im-deltax/Robodeltax/Trang_Phuc/Rap_Kimono_V20_mm.dxf

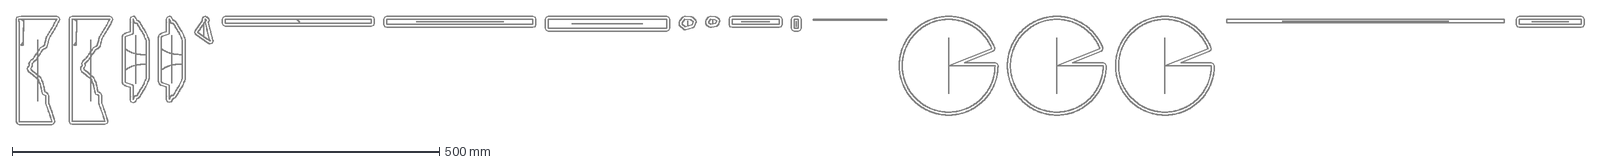
[picture p1: CAD file, 2026-10-22]
Trang_Phuc/Rap_Kimono_V20_mm.dxf
1834.3 x 126.7 mm
