im-deltax/Robodeltax/(list of files, cad)

Other CAD files:
Nguon_CAD_Giu_Lai/FreeCAD_V19/Micro_Duck_Cloak_V19_Assembly.FCStd
Nguon_CAD_Giu_Lai/Vo_nen_V11/Micro_Duck_Pumpkin_V11_A_Assembly.FCStd
Bien_Song_Trang_V11/May_Do_V11/02_Rap_V11_mm.dxf
Hoodie_Rong_Tim/Ho_So_May/02_Rap_Hoodie_Rong_Tim_mm.dxf
Hoodie_Rong_Tim_BANSAO/Ban_Sao_Vo_Ngoai_Theo_Anh/MicroDuck_VoNgoai_BANSAO.FCStd
Nguon_CAD_Giu_Lai/FreeCAD_V19/Micro_Duck_Cloak_V19_Cloak.step
Nguon_CAD_Giu_Lai/Robot_Kimono_V2.FCStd
Nguon_CAD_Giu_Lai/STEP/MagnetCapRight.step
Nguon_CAD_Giu_Lai/STL/K_LCD_den_tham_chieu.stl
Nguon_CAD_Giu_Lai/Vo_nen_V11/evidence/LCD_Module_Opaque_Reference.stl
Nguon_CAD_Giu_Lai/Vo_nen_V11/LCD_Display_Only.stl
Nguon_CAD_Giu_Lai/Vo_nen_V11/STL/Neck.stl
Thien_Van/Ho_So_May/Rap_Thien_Van_mm.dxf
Vo_In_3D/CAD/DELTAX_Man_1p9_V21.step
Vo_In_3D/STL/V16_Internal_head_locator.stl
Nguon_CAD_Giu_Lai/STEP/ArmLeft.step
Nguon_CAD_Giu_Lai/STL/K_LCD_noi_dung_tham_chieu.stl
Nguon_CAD_Giu_Lai/Vo_nen_V11/Lens_Thermoform_Male_Tool.step
Nguon_CAD_Giu_Lai/Vo_nen_V11/STL/USB_EndRail_Top_Piece_2.stl
Vo_In_3D/STL/HeadFront_LCD_1p9_V21.stl
Nguon_CAD_Giu_Lai/STEP/Lens_Rear_Opaque_Film.step
Nguon_CAD_Giu_Lai/Vo_nen_V11/STL/A_DeltaX_Engraved_Nameplate.stl
Vo_In_3D/STL/Base.stl
Nguon_CAD_Giu_Lai/STEP/LowerSupportInsert2.step
Nguon_CAD_Giu_Lai/Vo_nen_V11/STL/LCD_Front_Opaque_Shroud.stl
Vo_In_3D/STL/ArmRight.stl
Nguon_CAD_Giu_Lai/STEP/PumpkinHeadFront.step
Nguon_CAD_Giu_Lai/Vo_nen_V11/STL/PumpkinHeadRear.stl
Vo_In_3D/STL/A_DeltaX_Engraved_Nameplate.stl
Nguon_CAD_Giu_Lai/STEP/USB_EndRail_Top_Piece_2.step
Nguon_CAD_Giu_Lai/Vo_nen_V11/STL/Lens_PC_1p016_Target.stl
Vo_In_3D/STL/V16_Body_Front.stl
Nguon_CAD_Giu_Lai/STEP/PumpkinHeadRear.step
Nguon_CAD_Giu_Lai/Vo_nen_V11/STL/MagnetCapLeft.stl
Vo_In_3D/STL/LCD_Bracket_Left.stl
Nguon_CAD_Giu_Lai/STEP/Lens_Continuous_Gasket.step
Nguon_CAD_Giu_Lai/Vo_nen_V11/STL/MagnetCapRight.stl
Vo_In_3D/STL/SpeakerFrontRetainer.stl
Nguon_CAD_Giu_Lai/STEP/PumpkinBodyRear.step
Nguon_CAD_Giu_Lai/Vo_nen_V11/STL/LowerSupportInsert2.stl
Vo_In_3D/STL/LCD_Bracket_Right.stl
Nguon_CAD_Giu_Lai/STEP/Lens_PC_1p016_Target.step
Nguon_CAD_Giu_Lai/Vo_nen_V11/STL/LensSeatBezel.stl
Vo_In_3D/STL/HeadRear_LCD_1p9_V21.stl
Nguon_CAD_Giu_Lai/STEP/ArmRight.step
Nguon_CAD_Giu_Lai/Vo_nen_V11/STL/UpperSupportInsert2.stl
Vo_In_3D/STL/LCD_Light_Tunnel_V21.stl
Nguon_CAD_Giu_Lai/STEP/USB_EndRail_Top_Piece_1.step
Nguon_CAD_Giu_Lai/Vo_nen_V11/STL/UpperSupportInsert1.stl
Vo_In_3D/STL/V16_Body_Rear.stl
Nguon_CAD_Giu_Lai/STEP/A_DeltaX_Engraved_Nameplate.step
Nguon_CAD_Giu_Lai/Vo_nen_V11/STL/Lens_Rear_Opaque_Film.stl
Vo_In_3D/STL/V16_Arm_locating_peg_-1.stl
Nguon_CAD_Giu_Lai/STEP/K_Mat_cuoi_minh_hoa.step
Nguon_CAD_Giu_Lai/Vo_nen_V11/STL/Lens_Continuous_Gasket.stl
Vo_In_3D/STL/BaseCover.stl
Nguon_CAD_Giu_Lai/STEP/UpperSupportInsert1.step
Nguon_CAD_Giu_Lai/Vo_nen_V11/STL/A_DeltaX_Recessed_Gold_Inlay.stl
Vo_In_3D/STL/A_DeltaX_Recessed_Gold_Inlay.stl
Nguon_CAD_Giu_Lai/STEP/MagnetCapLeft.step
Nguon_CAD_Giu_Lai/Vo_nen_V11/STL/BaseCover.stl
Vo_In_3D/STL/ArmLeft.stl
Nguon_CAD_Giu_Lai/STEP/V11_Internal_Core_Pedestal.step
Nguon_CAD_Giu_Lai/Vo_nen_V11/STL/PumpkinBodyRear.stl
Nguon_CAD_Giu_Lai/STEP/BaseCover.step
Nguon_CAD_Giu_Lai/Vo_nen_V11/STL/V11_Internal_Core_Pedestal.stl
Nguon_CAD_Giu_Lai/STEP/Neck.step
Nguon_CAD_Giu_Lai/Vo_nen_V11/STL/USB_EndRail_Top_Piece_1.stl
Nguon_CAD_Giu_Lai/STEP/LensSeatBezel.step
Nguon_CAD_Giu_Lai/Vo_nen_V11/STL/PumpkinBodyFront.stl
Nguon_CAD_Giu_Lai/STEP/LCD_Front_Opaque_Shroud.step
Nguon_CAD_Giu_Lai/Vo_nen_V11/STL/USB_EndRail_Bottom.stl
Nguon_CAD_Giu_Lai/STEP/USB_EndRail_Bottom.step
Nguon_CAD_Giu_Lai/Vo_nen_V11/STL/Base.stl
Nguon_CAD_Giu_Lai/STEP/UpperSupportInsert2.step
Nguon_CAD_Giu_Lai/Vo_nen_V11/STL/PumpkinHeadFront.stl
Nguon_CAD_Giu_Lai/STEP/LowerSupportInsert1.step
Nguon_CAD_Giu_Lai/Vo_nen_V11/STL/SpeakerFrontRetainer.stl
Nguon_CAD_Giu_Lai/STEP/PumpkinBodyFront.step
Nguon_CAD_Giu_Lai/Vo_nen_V11/STL/LowerSupportInsert1.stl
Nguon_CAD_Giu_Lai/STEP/SpeakerFrontRetainer.step
Nguon_CAD_Giu_Lai/STEP/Base.step
Nguon_CAD_Giu_Lai/STEP/A_DeltaX_Recessed_Gold_Inlay.step
Bien_Song_Trang_V11/Robot_Bien_Song_Trang_V11.blend
Blender/Robot_Kimono_Man_1p9_V21.blend
Hoodie_Rong_Tim/Micro_Duck_Hoodie_Rong_Tim.blend
Hoodie_Rong_Tim_BANSAO/Ban_Sao_Vo_Ngoai_Theo_Anh/MicroDuck_HoodieRong_VoNgoai_BANSAO.blend
Hoodie_Rong_Tim_BANSAO/Ban_Theo_Dac_Ta_Ni_Bong/MicroDuck_HoodieRong_NiBong_BANSAO.blend
Hoodie_Rong_Tim_BANSAO/Ban_Tu_Kiem_Tra/MicroDuck_HoodieRong_TuKiemTra_BANSAO.blend
Hoodie_Rong_Tim_BANSAO/Bo_Trang_Phuc_Day_Du/MicroDuck_HoodieRong_DayDu_BANSAO.blend
Hoodie_Rong_Tim_BANSAO/MicroDuck_HoodieRong_BANSAO.blend
Hoodie_Rong_Tim_ThietKeMoi/MicroDuck_HoodieRong_BANSAO.blend
Nguon_CAD_Giu_Lai/FreeCAD_V19/Micro_Duck_Cloak_V19_Cloak.FCStd
Nguon_CAD_Giu_Lai/STL/A_DeltaX_Engraved_Nameplate.stl
Nguon_CAD_Giu_Lai/STL/A_DeltaX_Recessed_Gold_Inlay.stl
Nguon_CAD_Giu_Lai/STL/ArmLeft.stl
Nguon_CAD_Giu_Lai/STL/ArmRight.stl
Nguon_CAD_Giu_Lai/STL/Base.stl
Nguon_CAD_Giu_Lai/STL/BaseCover.stl
Nguon_CAD_Giu_Lai/STL/K_Mat_cuoi_minh_hoa.stl
Nguon_CAD_Giu_Lai/STL/LCD_Front_Opaque_Shroud.stl
Nguon_CAD_Giu_Lai/STL/LensSeatBezel.stl
Nguon_CAD_Giu_Lai/STL/Lens_Continuous_Gasket.stl
Nguon_CAD_Giu_Lai/STL/Lens_PC_1p016_Target.stl
Nguon_CAD_Giu_Lai/STL/Lens_Rear_Opaque_Film.stl
Nguon_CAD_Giu_Lai/STL/LowerSupportInsert1.stl
Nguon_CAD_Giu_Lai/STL/LowerSupportInsert2.stl
Nguon_CAD_Giu_Lai/STL/MagnetCapLeft.stl
Nguon_CAD_Giu_Lai/STL/MagnetCapRight.stl
Nguon_CAD_Giu_Lai/STL/Neck.stl
Nguon_CAD_Giu_Lai/STL/PumpkinBodyFront.stl
Nguon_CAD_Giu_Lai/STL/PumpkinBodyRear.stl
Nguon_CAD_Giu_Lai/STL/PumpkinHeadFront.stl
Nguon_CAD_Giu_Lai/STL/PumpkinHeadRear.stl
Nguon_CAD_Giu_Lai/STL/SpeakerFrontRetainer.stl
Nguon_CAD_Giu_Lai/STL/USB_EndRail_Bottom.stl
Nguon_CAD_Giu_Lai/STL/USB_EndRail_Top_Piece_1.stl
Nguon_CAD_Giu_Lai/STL/USB_EndRail_Top_Piece_2.stl
Nguon_CAD_Giu_Lai/STL/UpperSupportInsert1.stl
Nguon_CAD_Giu_Lai/STL/UpperSupportInsert2.stl
Nguon_CAD_Giu_Lai/STL/V11_Internal_Core_Pedestal.stl
Thien_Van/Robot_Thien_Van.blend
Vo_In_3D/CAD/DELTAX_Man_1p9_V21.FCStd
Vo_In_3D/STL/V16_Arm_locating_peg_1.stl
