im-deltax/Robodeltax/Dien_Tu/KiCad/Charge_Port/DELTAX_V2_Charge_Port.kicad_pcb

## KiCad design Dien_Tu/KiCad/Charge_Port/DELTAX_V2_Charge_Port.kicad_pcb (2026-10-22)

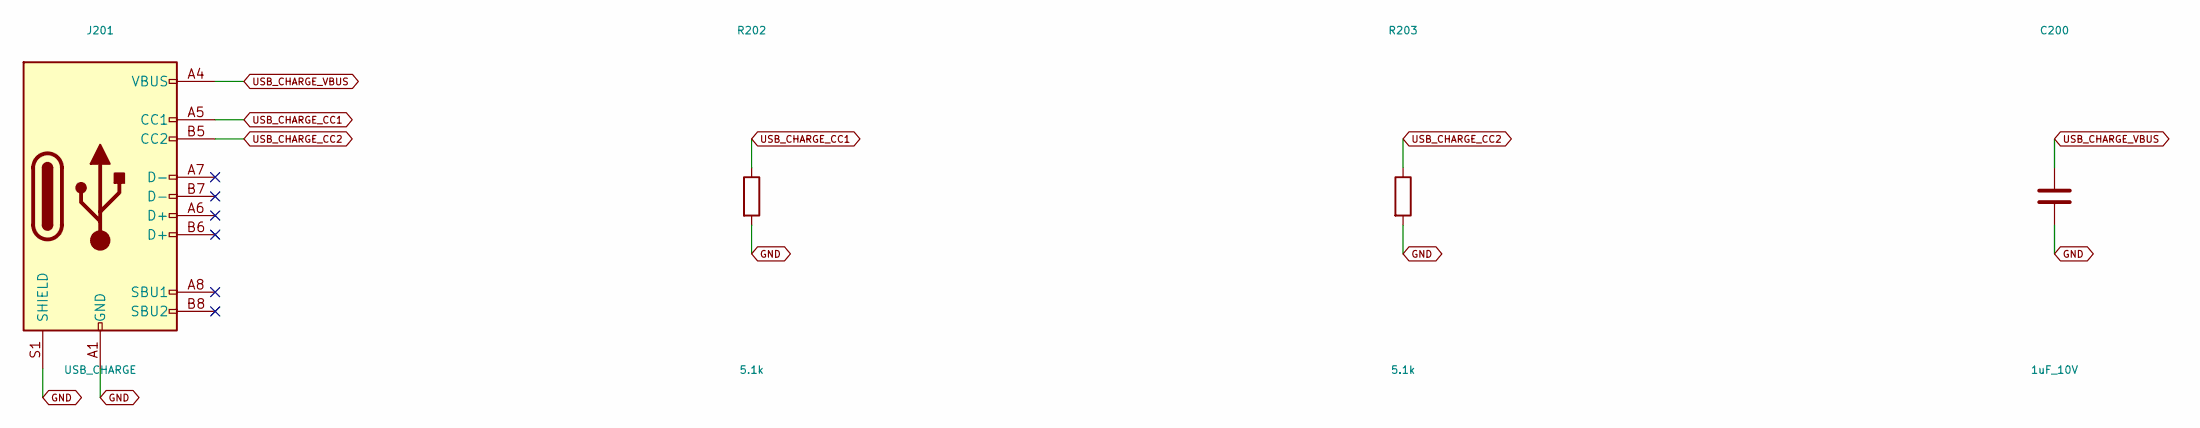
[picture p2: schematic Charge_Port_09_USB_Charge.kicad_sch]

Parts:
C200: 1uF_10V; C_0603_1608Metric
J201: USB_CHARGE; USB_C_Receptacle_GCT_USB4105-xx-A_16P_TopMnt_Horizontal
R202, R203: 5.1k; R_0603_1608Metric

Connections:
GND: C200.2, J201.A1 (GND), J201.A12 (GND), J201.B1 (GND), J201.B12 (GND), J201.S1 (SHIELD), R202.2, R203.2; also elsewhere on the board
USB_CHARGE_CC1: J201.A5 (CC1), R202.1
USB_CHARGE_CC2: J201.B5 (CC2), R203.1
USB_CHARGE_VBUS: C200.1, J201.A4 (VBUS), J201.A9 (VBUS), J201.B4 (VBUS), J201.B9 (VBUS); also elsewhere on the board

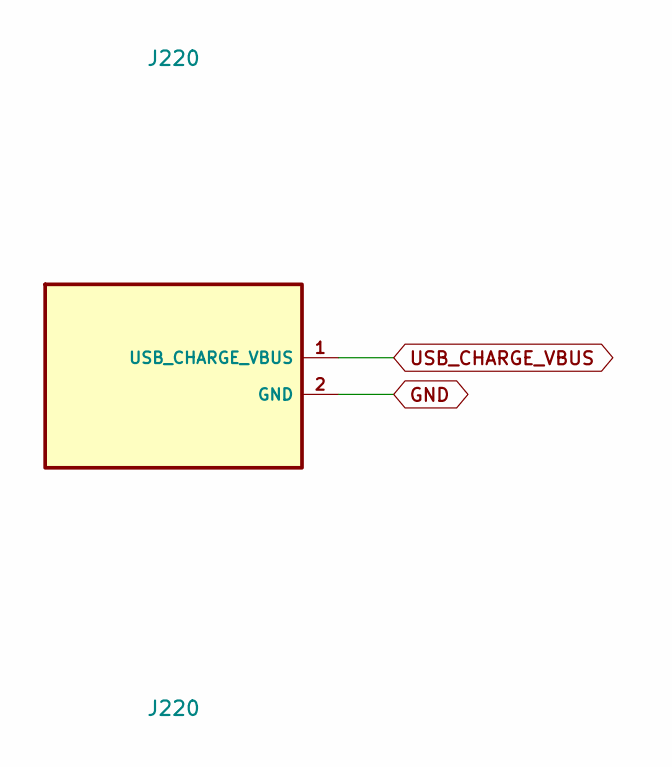
[picture p3: schematic Charge_Port_Interface.kicad_sch]

Parts:
J220: J220; PowerPads_2

Connections:
GND: J220.2 (GND); also elsewhere on the board
USB_CHARGE_VBUS: J220.1 (USB_CHARGE_VBUS); also elsewhere on the board

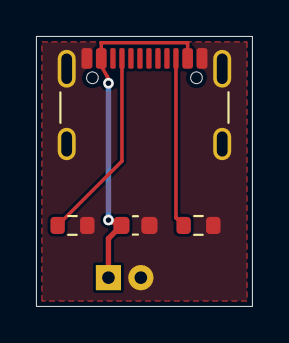
[picture p4: board DELTAX_V2_Charge_Port.kicad_pcb from above]

Board: 2 copper layers, 12.0 x 15.0 mm, 5 parts (0 on the bottom side), 4 nets.
