im-deltax/Robodeltax/Dien_Tu/KiCad/Head/DELTAX_V2_Head.kicad_pcb

## KiCad design Dien_Tu/KiCad/Head/DELTAX_V2_Head.kicad_pcb (2026-10-22)

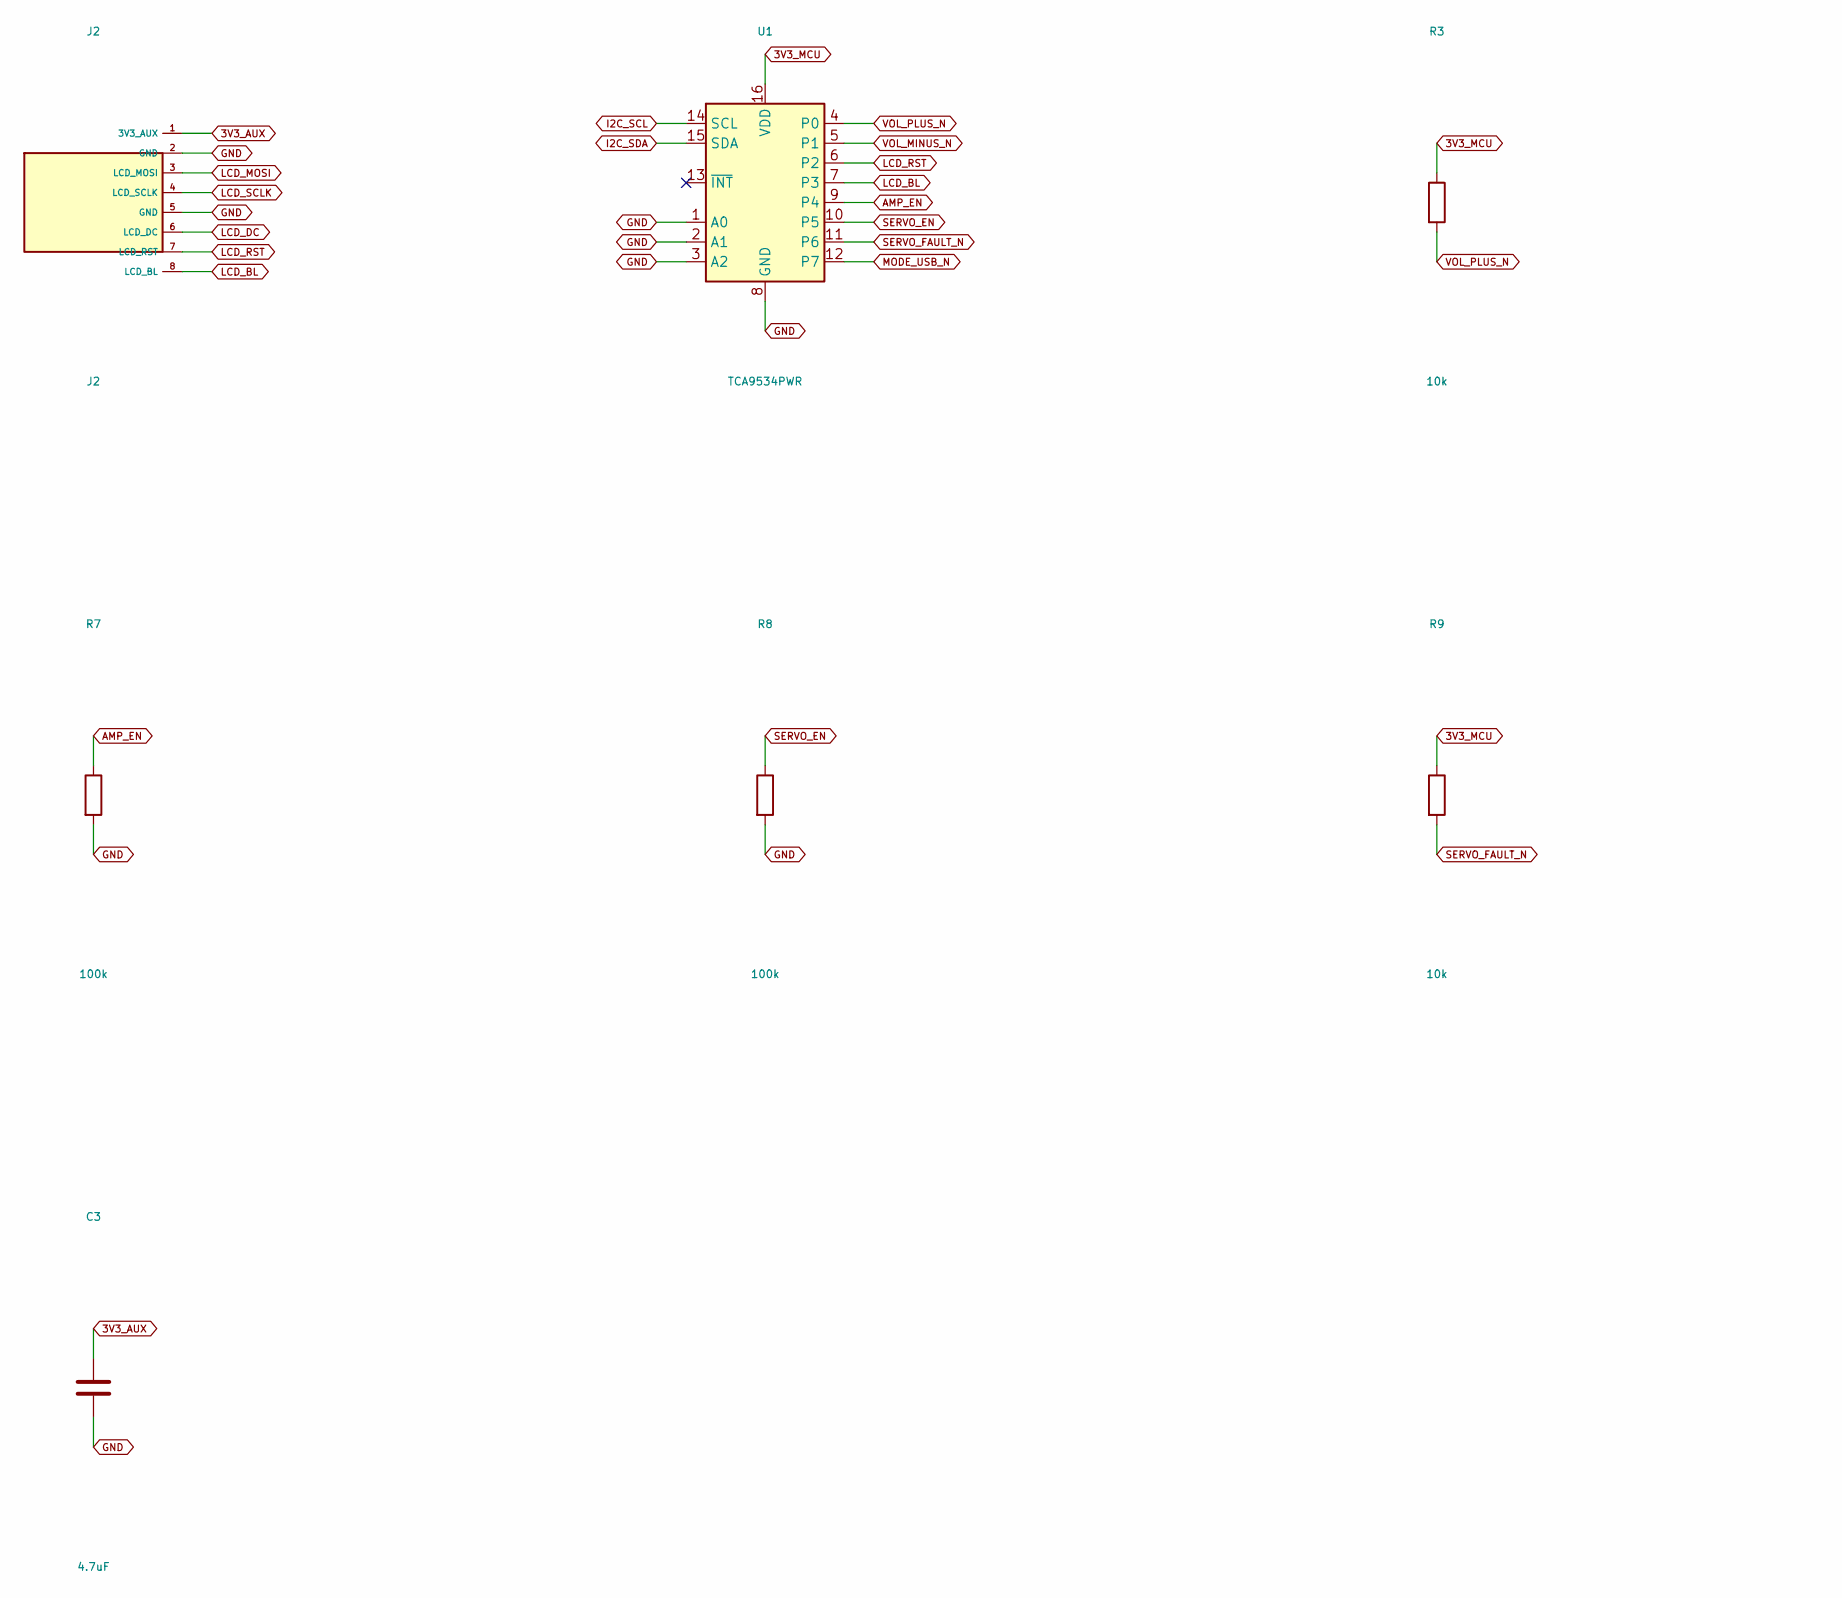
[picture p5: schematic Head_01_Module_LCD_Control.kicad_sch, part in row 1, column 1]

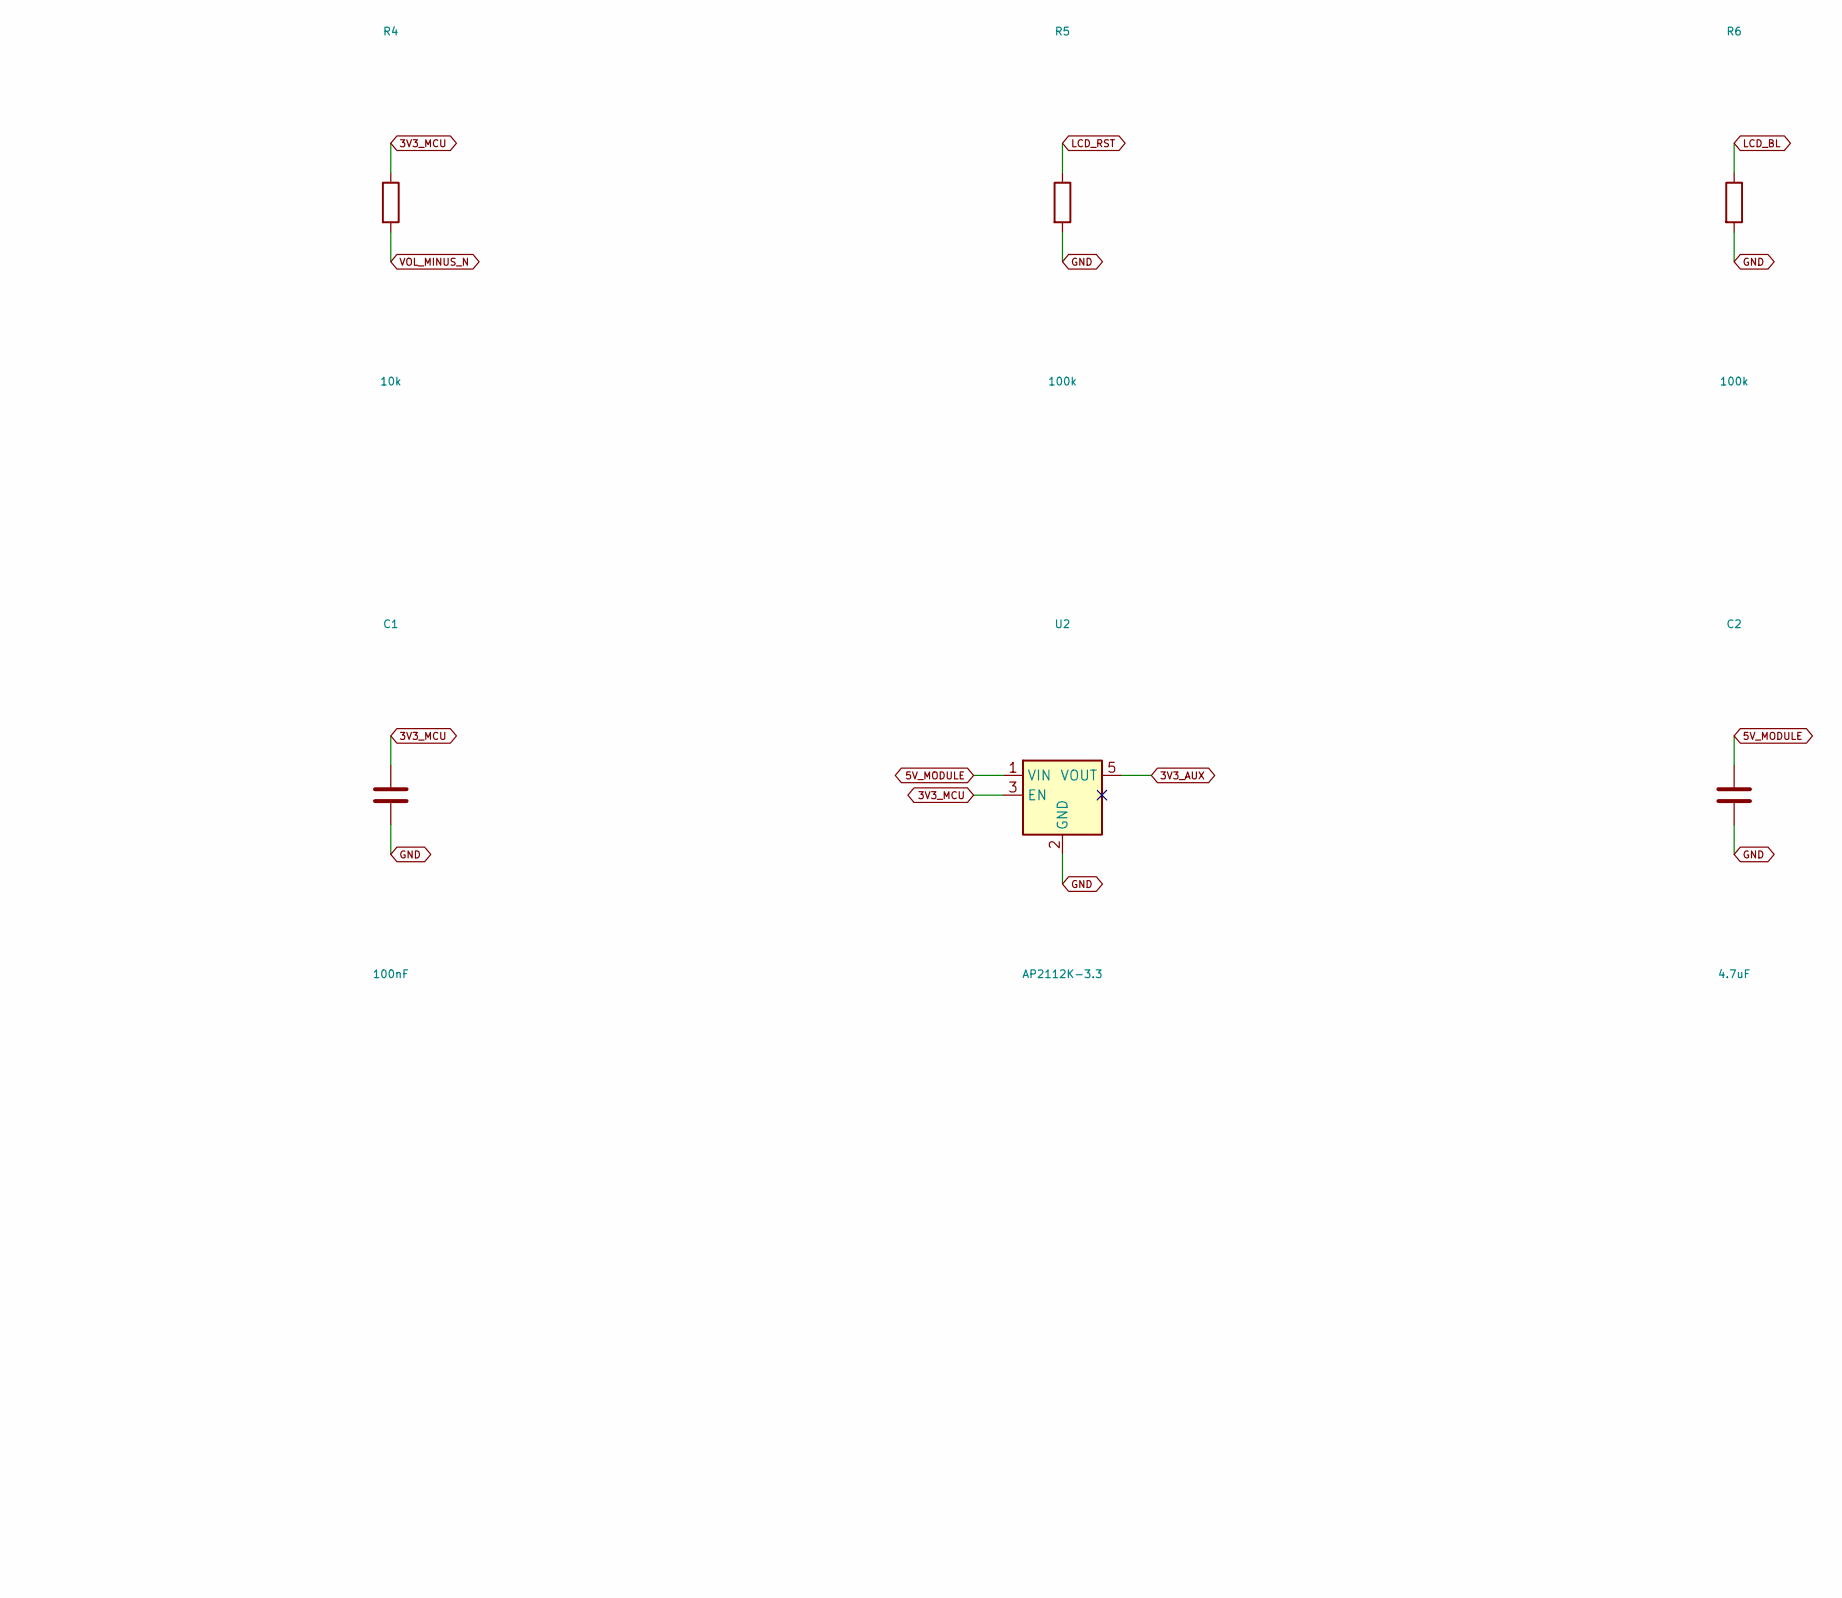
[picture p6: schematic Head_01_Module_LCD_Control.kicad_sch, part in row 1, column 2]

Parts:
C1: 100nF; C_0603_1608Metric
C2, C3: 4.7uF; C_0603_1608Metric
J2: J2; JST_GH_SM08B-GHS-TB_1x08-1MP_P1.25mm_Horizontal
R3, R4, R9: 10k; R_0603_1608Metric
R5, R6, R7, R8: 100k; R_0603_1608Metric
U1: TCA9534PWR; TSSOP-16_4.4x5mm_P0.65mm
U2: AP2112K-3.3; SOT-23-5

Connections:
3V3_AUX: C3.1, J2.1 (3V3_AUX), U2.5 (VOUT)
3V3_MCU: C1.1, R3.1, R4.1, R9.1, U1.16 (VDD), U2.3 (EN); also elsewhere on the board
5V_MODULE: C2.1, U2.1 (VIN); also elsewhere on the board
AMP_EN: R7.1, U1.9 (P4); also elsewhere on the board
GND: C1.2, C2.2, C3.2, J2.2 (GND), J2.5 (GND), R5.2, R6.2, R7.2, R8.2, U1.1 (A0), U1.2 (A1), U1.3 (A2), U1.8 (GND), U2.2 (GND); also elsewhere on the board
I2C_SCL: U1.14 (SCL); also elsewhere on the board
I2C_SDA: U1.15 (SDA); also elsewhere on the board
LCD_BL: J2.8 (LCD_BL), R6.1, U1.7 (P3)
LCD_DC: J2.6 (LCD_DC); also elsewhere on the board
LCD_MOSI: J2.3 (LCD_MOSI); also elsewhere on the board
LCD_RST: J2.7 (LCD_RST), R5.1, U1.6 (P2)
LCD_SCLK: J2.4 (LCD_SCLK); also elsewhere on the board
MODE_USB_N: U1.12 (P7); also elsewhere on the board
SERVO_EN: R8.1, U1.10 (P5); also elsewhere on the board
SERVO_FAULT_N: R9.2, U1.11 (P6); also elsewhere on the board
VOL_MINUS_N: R4.2, U1.5 (P1); also elsewhere on the board
VOL_PLUS_N: R3.2, U1.4 (P0); also elsewhere on the board

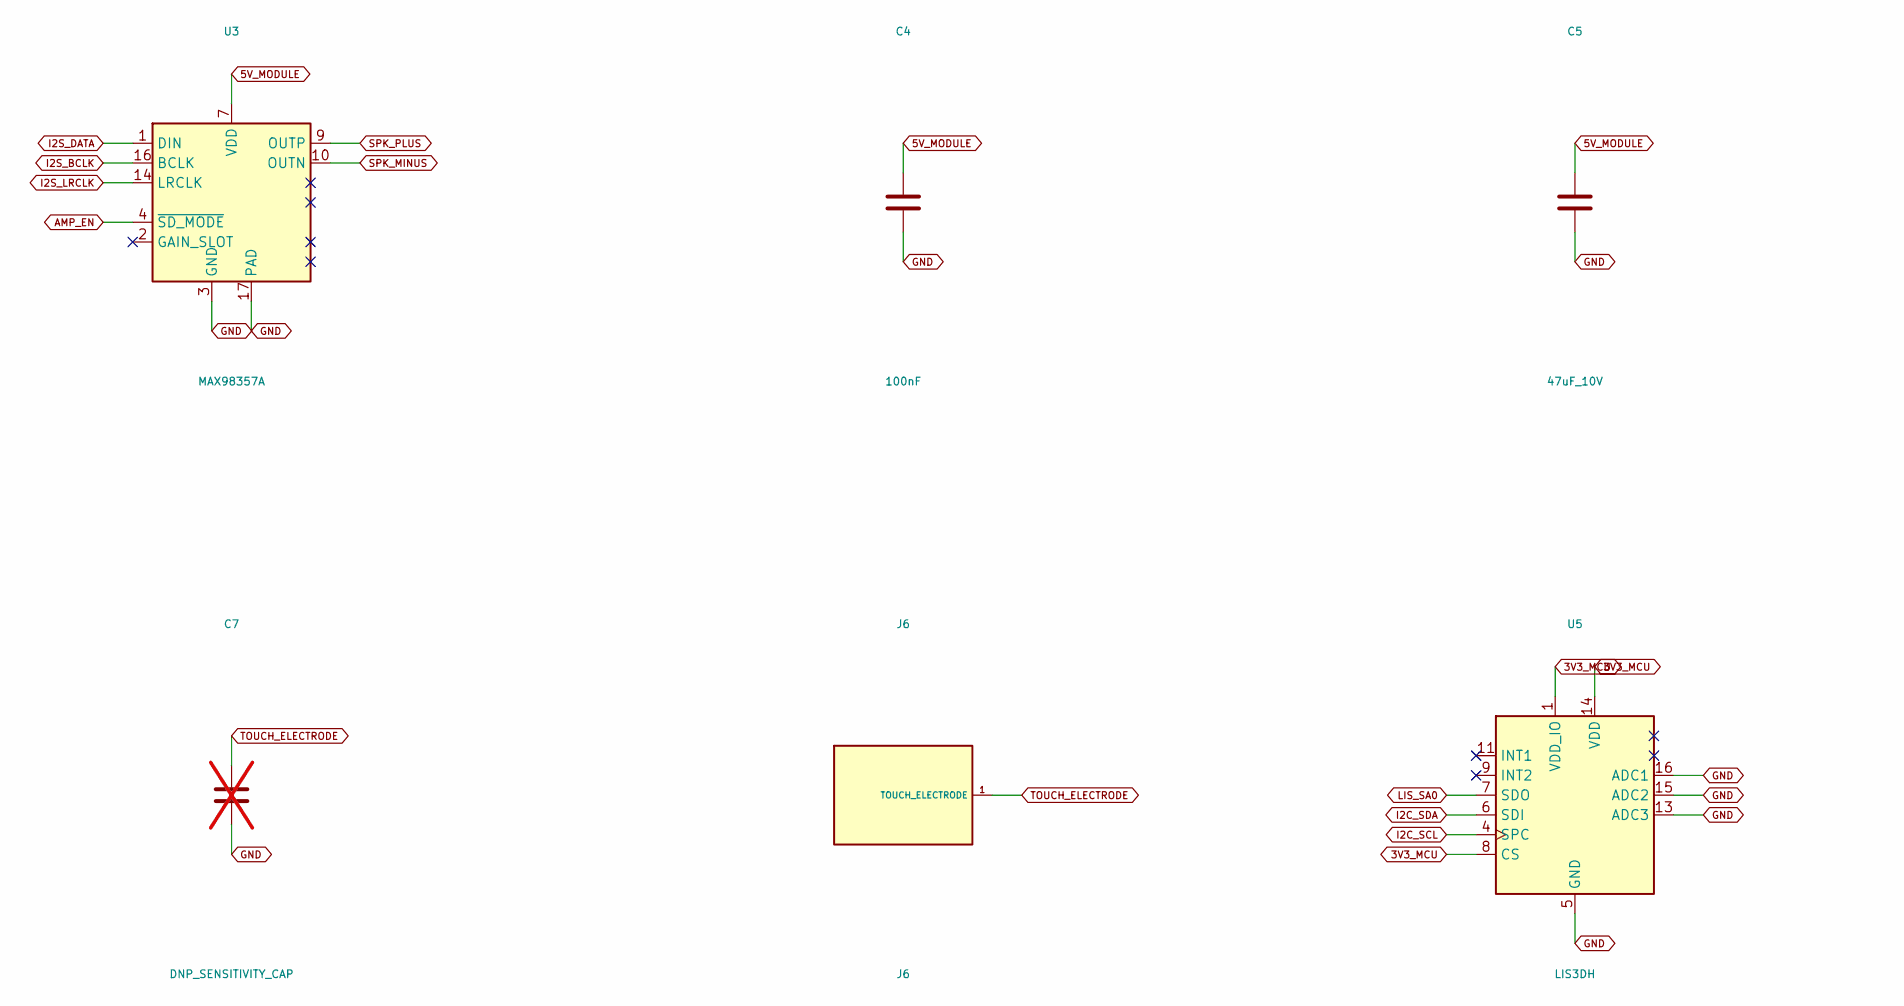
[picture p7: schematic Head_02_Audio_Touch_Shake.kicad_sch, part in row 1, column 1]

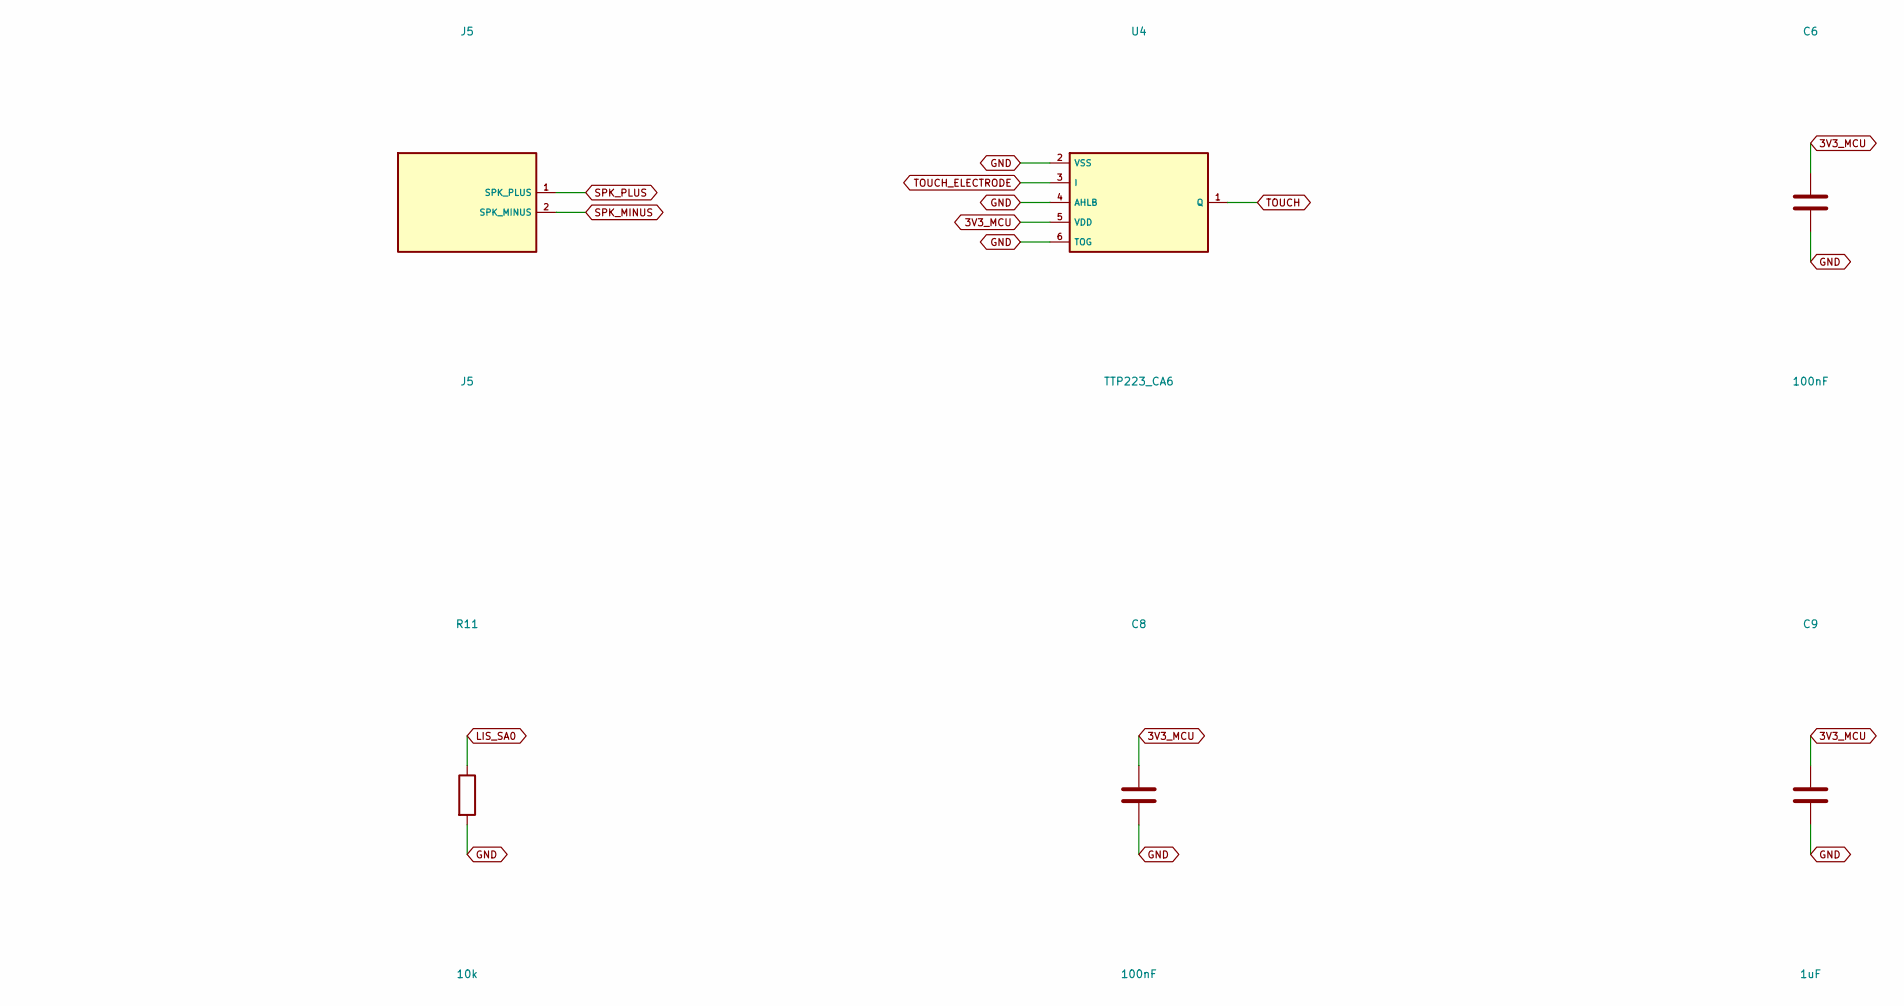
[picture p8: schematic Head_02_Audio_Touch_Shake.kicad_sch, part in row 1, column 2]

Parts:
C4: 100nF; C_0402_1005Metric
C5: 47uF_10V; C_0805_2012Metric
C6, C8: 100nF; C_0603_1608Metric
C7: DNP_SENSITIVITY_CAP; C_0603_1608Metric; not fitted
C9: 1uF; C_0603_1608Metric
J5: J5; WirePads_2
J6: J6; WirePads_1
R11: 10k; R_0603_1608Metric
U3: MAX98357A; TQFN-16-1EP_3x3mm_P0.5mm_EP1.23x1.23mm
U4: TTP223_CA6; SOT-23-6
U5: LIS3DH; LGA-16_3x3mm_P0.5mm_LayoutBorder3x5y

Connections:
3V3_MCU: C6.1, C8.1, C9.1, U4.5 (VDD), U5.1 (VDD_IO), U5.8 (CS), U5.14 (VDD); also elsewhere on the board
5V_MODULE: C4.1, C5.1, U3.7 (VDD), U3.8 (VDD); also elsewhere on the board
AMP_EN: U3.4 (~SD_MODE); also elsewhere on the board
GND: C4.2, C5.2, C6.2, C7.2, C8.2, C9.2, R11.2, U3.3 (GND), U3.11 (GND), U3.15 (GND), U3.17 (PAD), U4.2 (VSS), U4.4 (AHLB), U4.6 (TOG), U5.5 (GND), U5.10 (GND), U5.12 (GND), U5.13 (ADC3), U5.15 (ADC2), U5.16 (ADC1); also elsewhere on the board
I2C_SCL: U5.4 (SPC); also elsewhere on the board
I2C_SDA: U5.6 (SDI); also elsewhere on the board
I2S_BCLK: U3.16 (BCLK); also elsewhere on the board
I2S_DATA: U3.1 (DIN); also elsewhere on the board
I2S_LRCLK: U3.14 (LRCLK); also elsewhere on the board
LIS_SA0: R11.1, U5.7 (SDO)
SPK_MINUS: J5.2 (SPK_MINUS), U3.10 (OUTN)
SPK_PLUS: J5.1 (SPK_PLUS), U3.9 (OUTP)
TOUCH: U4.1 (Q); also elsewhere on the board
TOUCH_ELECTRODE: C7.1, J6.1, U4.3 (I)

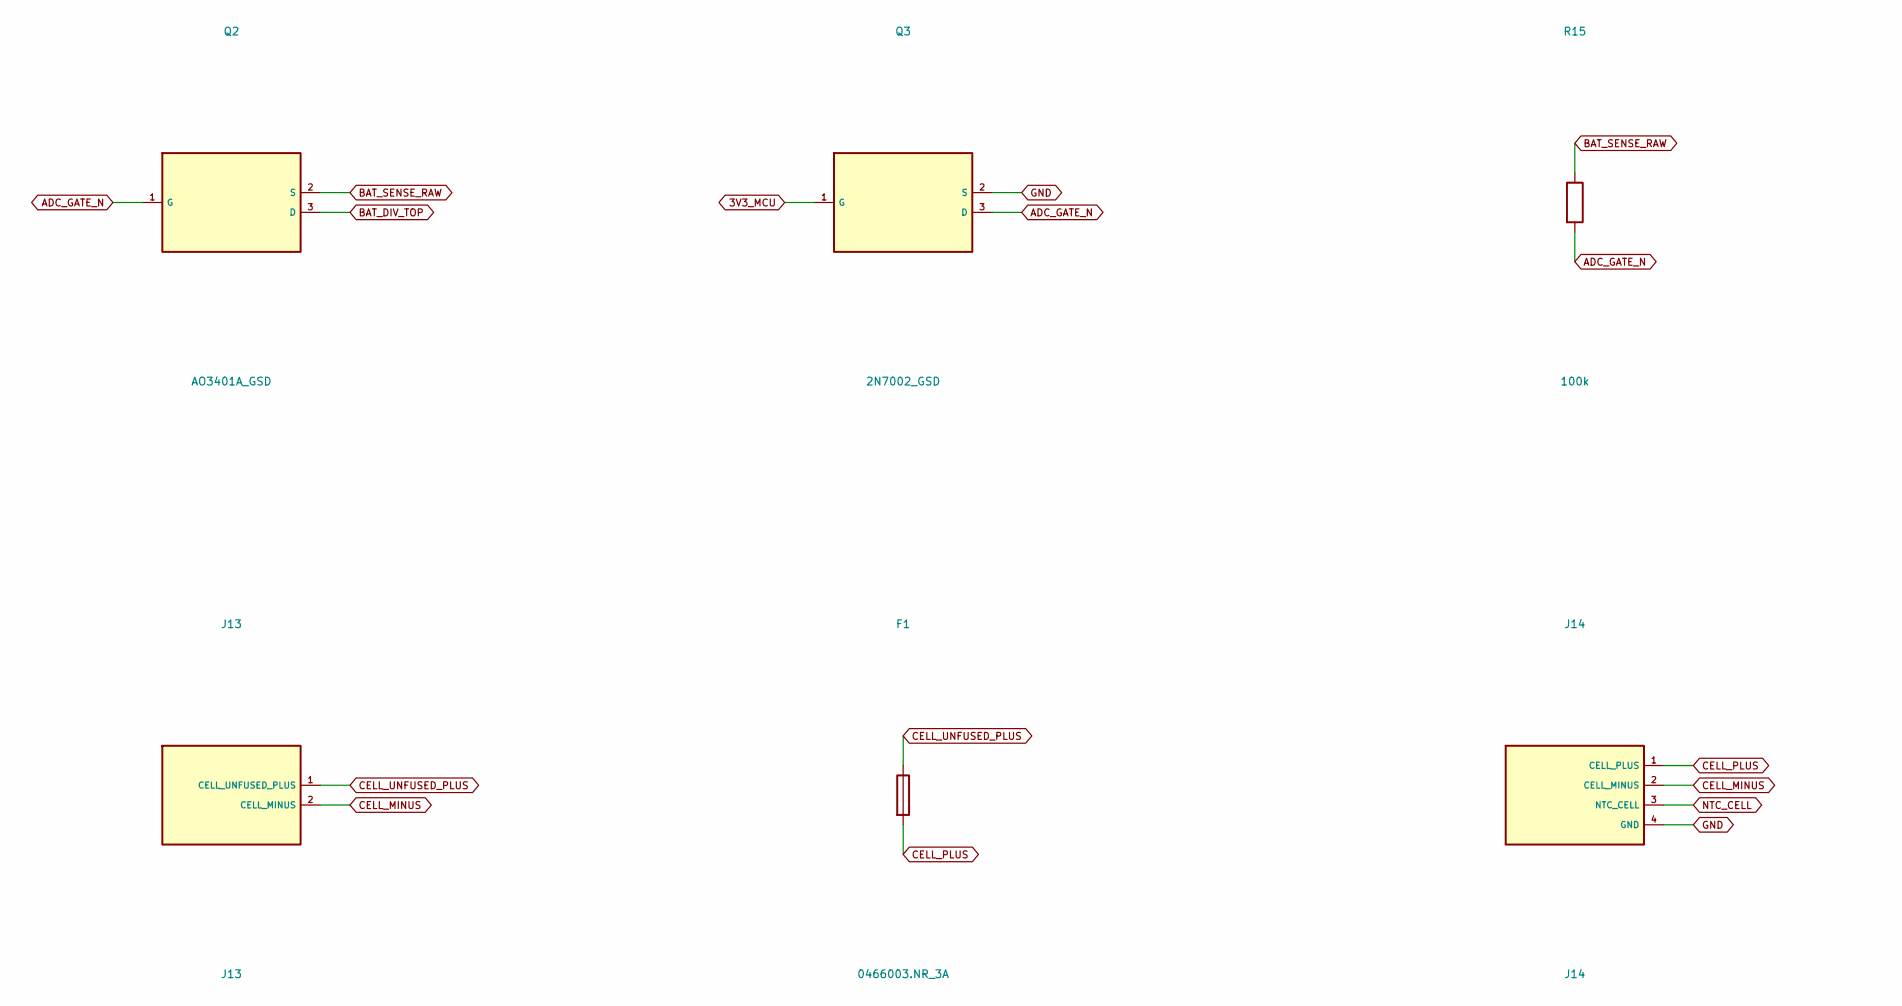
[picture p9: schematic Head_04_Battery_Sense.kicad_sch, part in row 1, column 1]

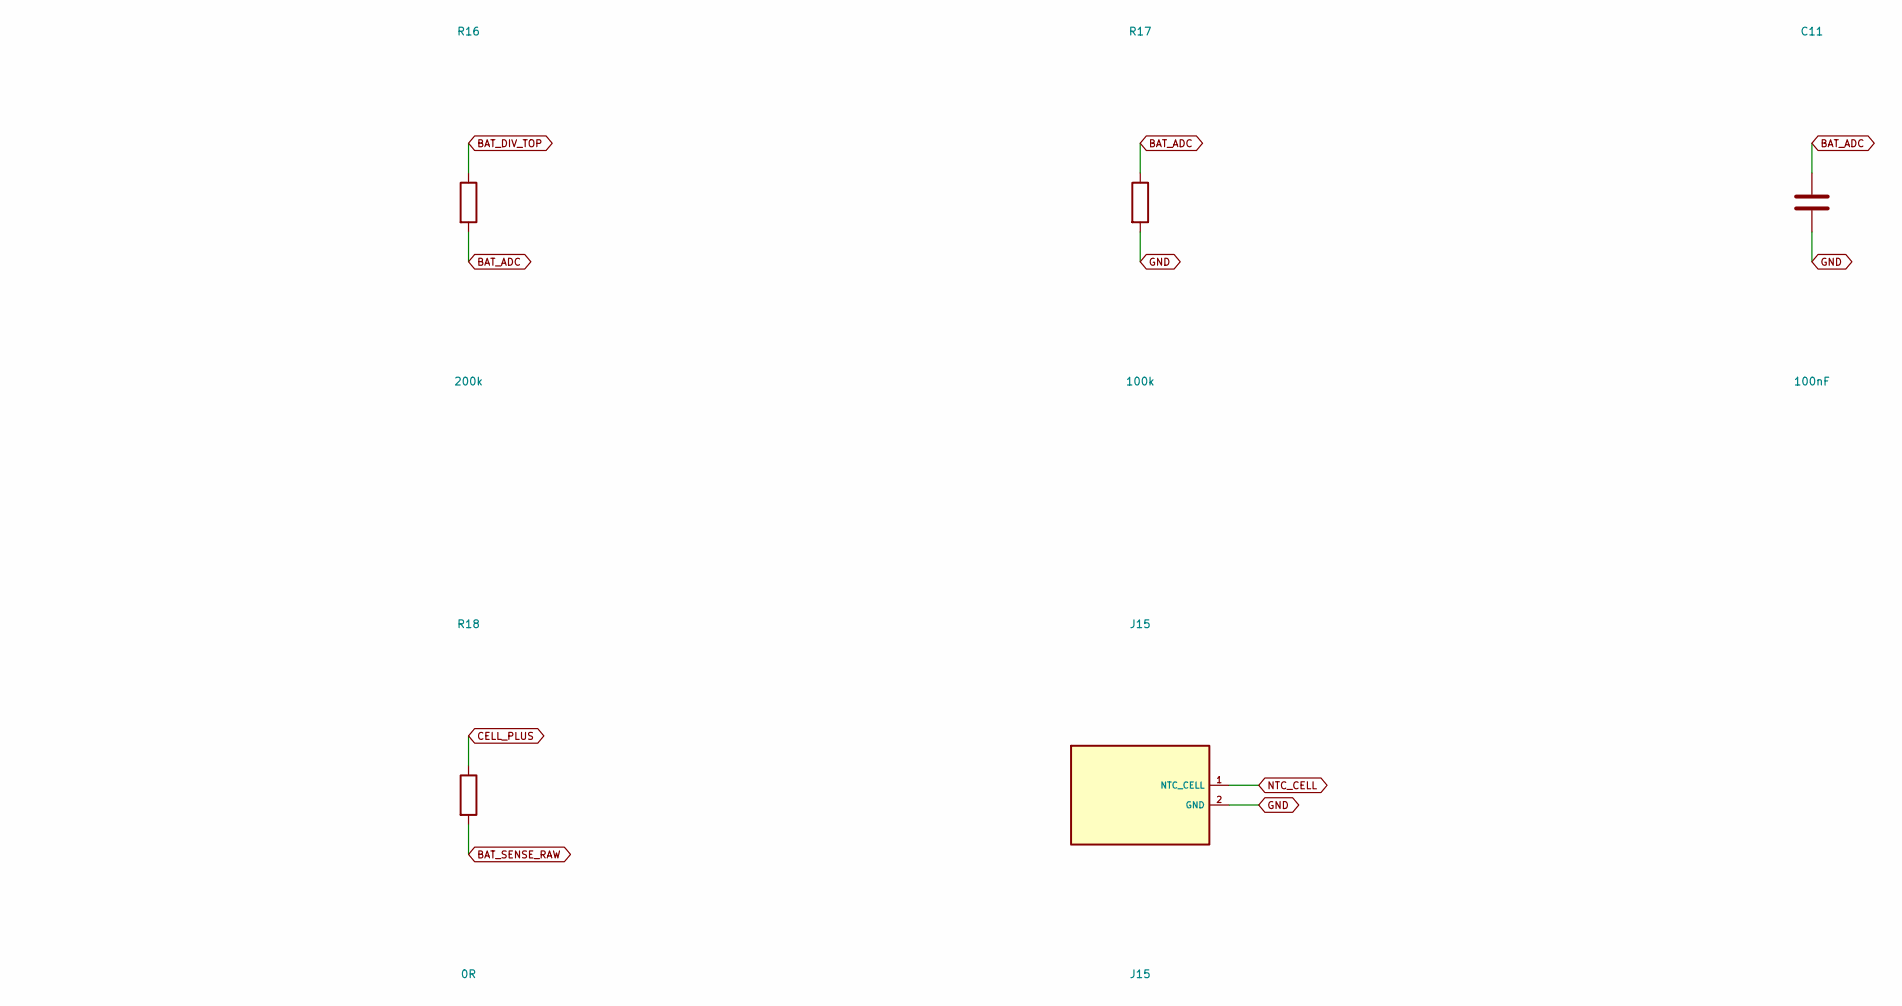
[picture p10: schematic Head_04_Battery_Sense.kicad_sch, part in row 1, column 2]

Parts:
C11: 100nF; C_0603_1608Metric
F1: 0466003.NR_3A; Fuse_1206_3216Metric
J13: J13; PowerPads_2
J14: J14; PowerPads_4
J15: J15; WirePads_2
Q2: AO3401A_GSD; SOT-23
Q3: 2N7002_GSD; SOT-23
R15, R17: 100k; R_0603_1608Metric
R16: 200k; R_0603_1608Metric
R18: 0R; R_0603_1608Metric

Connections:
3V3_MCU: Q3.1 (G); also elsewhere on the board
ADC_GATE_N: Q2.1 (G), Q3.3 (D), R15.2
BAT_ADC: C11.1, R16.2, R17.1; also elsewhere on the board
BAT_DIV_TOP: Q2.3 (D), R16.1
BAT_SENSE_RAW: Q2.2 (S), R15.1, R18.2
CELL_MINUS: J13.2 (CELL_MINUS), J14.2 (CELL_MINUS)
CELL_PLUS: F1.2, J14.1 (CELL_PLUS), R18.1
CELL_UNFUSED_PLUS: F1.1, J13.1 (CELL_UNFUSED_PLUS)
GND: C11.2, J14.4 (GND), J15.2 (GND), Q3.2 (S), R17.2; also elsewhere on the board
NTC_CELL: J14.3 (NTC_CELL), J15.1 (NTC_CELL)

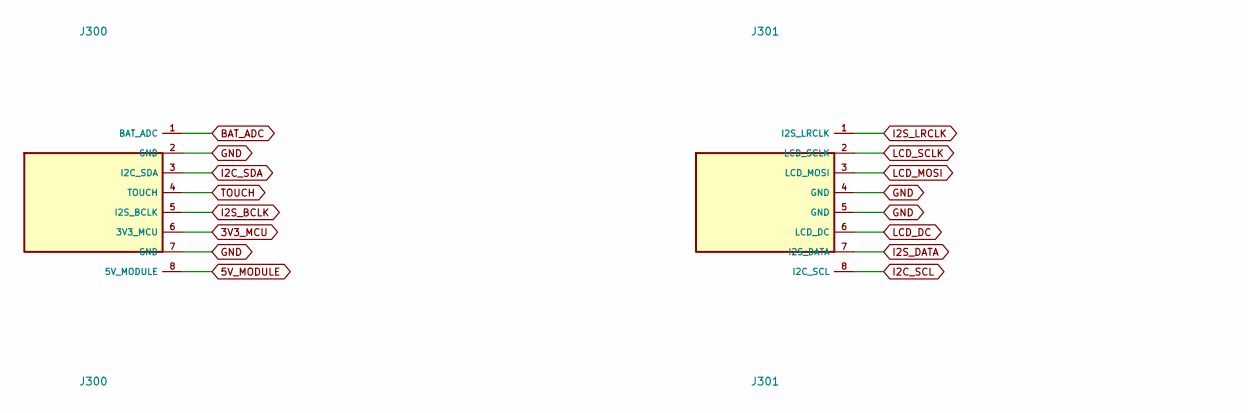
[picture p11: schematic Head_Interface.kicad_sch, part in row 1, column 1]

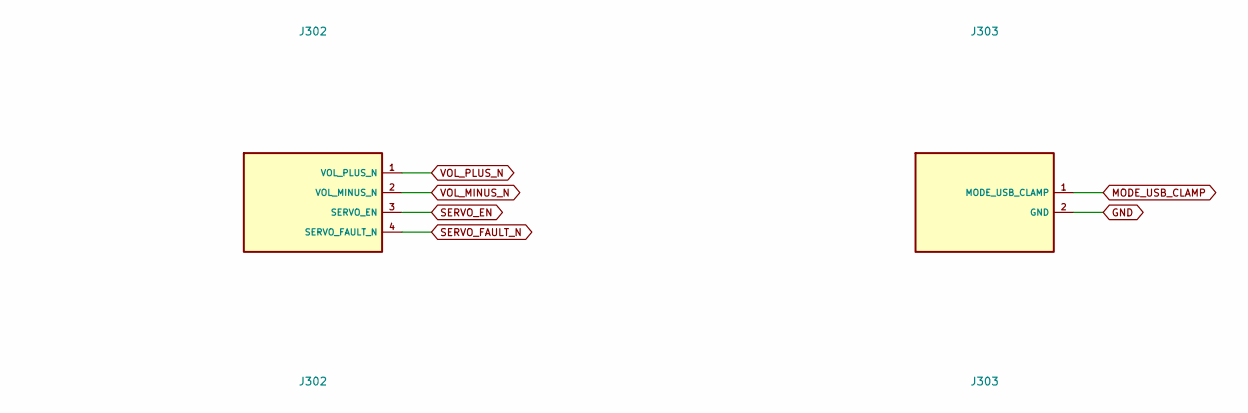
[picture p12: schematic Head_Interface.kicad_sch, part in row 1, column 2]

Parts:
J300: J300; WirePads_8
J301: J301; WirePads_8
J302: J302; WirePads_4
J303: J303; WirePads_2

Connections:
3V3_MCU: J300.6 (3V3_MCU); also elsewhere on the board
5V_MODULE: J300.8 (5V_MODULE); also elsewhere on the board
BAT_ADC: J300.1 (BAT_ADC); also elsewhere on the board
GND: J300.2 (GND), J300.7 (GND), J301.4 (GND), J301.5 (GND), J303.2 (GND); also elsewhere on the board
I2C_SCL: J301.8 (I2C_SCL); also elsewhere on the board
I2C_SDA: J300.3 (I2C_SDA); also elsewhere on the board
I2S_BCLK: J300.5 (I2S_BCLK); also elsewhere on the board
I2S_DATA: J301.7 (I2S_DATA); also elsewhere on the board
I2S_LRCLK: J301.1 (I2S_LRCLK); also elsewhere on the board
LCD_DC: J301.6 (LCD_DC); also elsewhere on the board
LCD_MOSI: J301.3 (LCD_MOSI); also elsewhere on the board
LCD_SCLK: J301.2 (LCD_SCLK); also elsewhere on the board
MODE_USB_CLAMP: J303.1 (MODE_USB_CLAMP); also elsewhere on the board
SERVO_EN: J302.3 (SERVO_EN); also elsewhere on the board
SERVO_FAULT_N: J302.4 (SERVO_FAULT_N); also elsewhere on the board
TOUCH: J300.4 (TOUCH); also elsewhere on the board
VOL_MINUS_N: J302.2 (VOL_MINUS_N); also elsewhere on the board
VOL_PLUS_N: J302.1 (VOL_PLUS_N); also elsewhere on the board

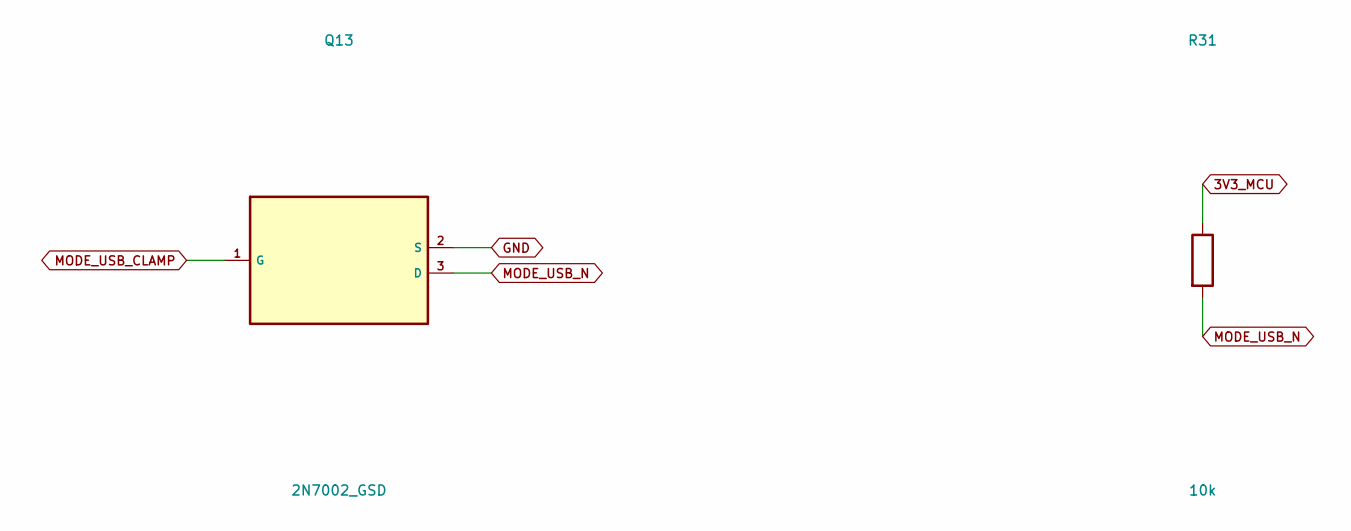
[picture p13: schematic Head_USB_BAT_Mode.kicad_sch]

Parts:
Q13: 2N7002_GSD; SOT-23
R31: 10k; R_0603_1608Metric

Connections:
3V3_MCU: R31.1; also elsewhere on the board
GND: Q13.2 (S); also elsewhere on the board
MODE_USB_CLAMP: Q13.1 (G); also elsewhere on the board
MODE_USB_N: Q13.3 (D), R31.2; also elsewhere on the board

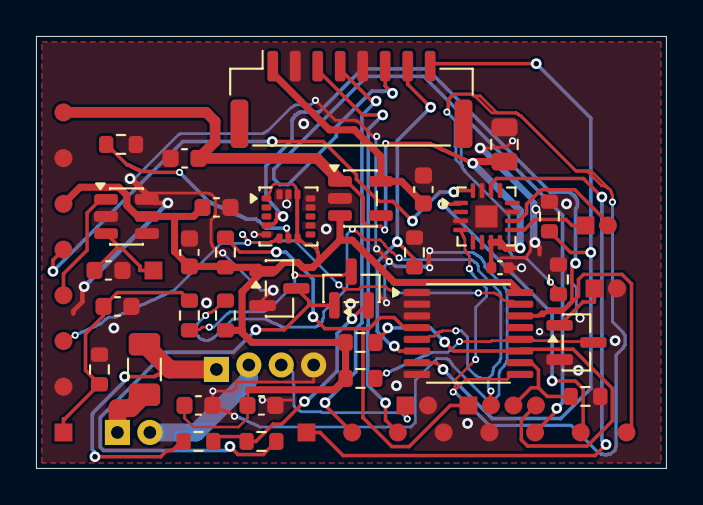
[picture p14: board DELTAX_V2_Head.kicad_pcb from above]

Board: 2 copper layers, 35.0 x 24.0 mm, 42 parts (0 on the bottom side), 34 nets.
