im-deltax/Robodeltax/Dien_Tu/KiCad/Controller/DELTAX_V2_Controller.kicad_pcb

## KiCad design Dien_Tu/KiCad/Controller/DELTAX_V2_Controller.kicad_pcb (2026-10-22)

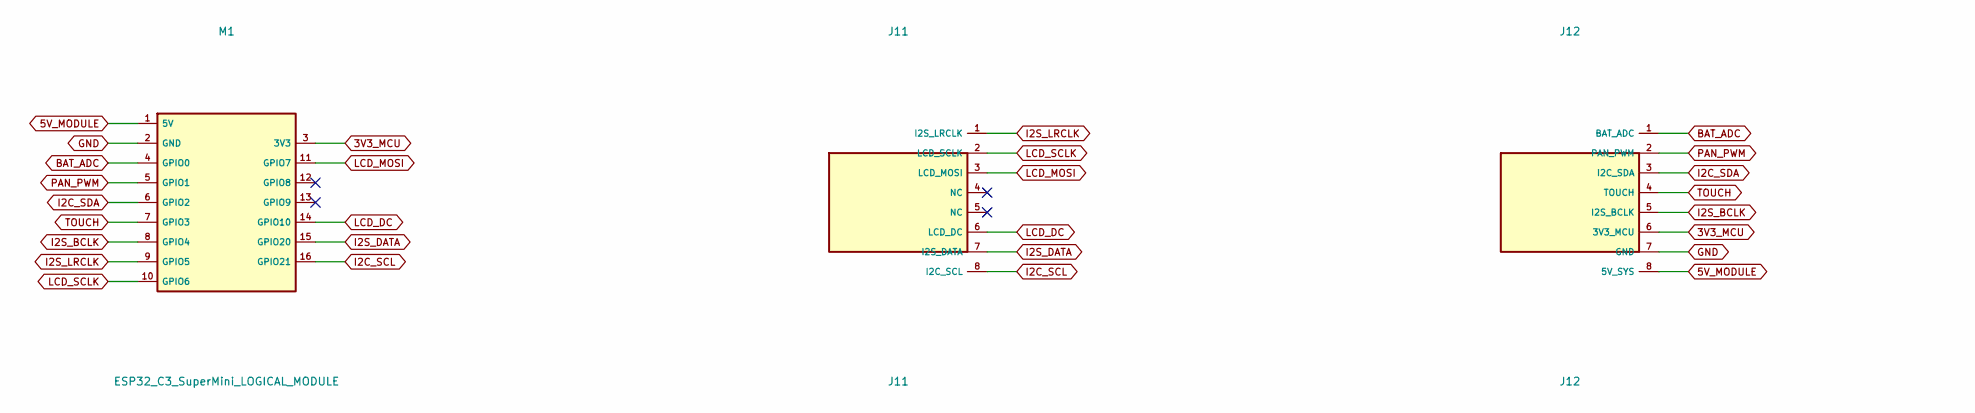
[picture p15: schematic Controller_01_Module_LCD_Control.kicad_sch, part in row 1, column 1]

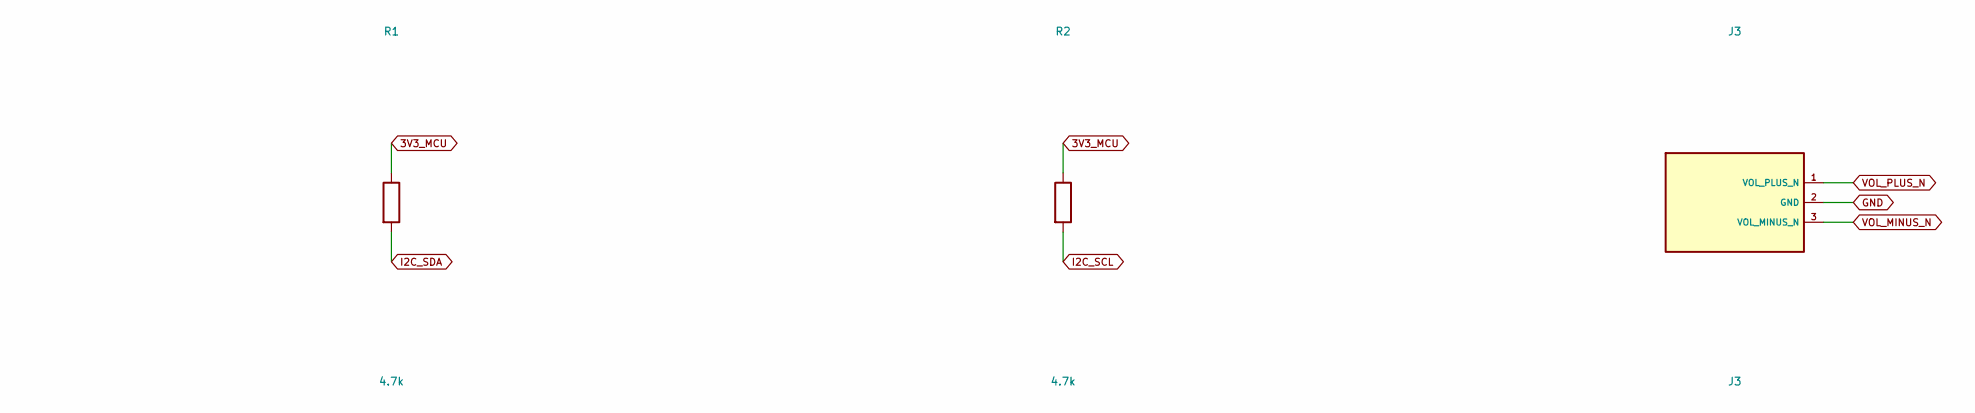
[picture p16: schematic Controller_01_Module_LCD_Control.kicad_sch, part in row 1, column 2]

Parts:
J3: J3; WirePads_3
J11: J11; SLW_108_LowProfile
J12: J12; SLW_108_LowProfile
M1: ESP32_C3_SuperMini_LOGICAL_MODULE
R1, R2: 4.7k; R_0603_1608Metric

Connections:
3V3_MCU: J12.6 (3V3_MCU), M1.3 (3V3), R1.1, R2.1; also elsewhere on the board
5V_MODULE: J12.8 (5V_SYS), M1.1 (5V); also elsewhere on the board
BAT_ADC: J12.1 (BAT_ADC), M1.4 (GPIO0); also elsewhere on the board
GND: J3.2 (GND), J12.7 (GND), M1.2 (GND); also elsewhere on the board
I2C_SCL: J11.8 (I2C_SCL), M1.16 (GPIO21), R2.2; also elsewhere on the board
I2C_SDA: J12.3 (I2C_SDA), M1.6 (GPIO2), R1.2; also elsewhere on the board
I2S_BCLK: J12.5 (I2S_BCLK), M1.8 (GPIO4); also elsewhere on the board
I2S_DATA: J11.7 (I2S_DATA), M1.15 (GPIO20); also elsewhere on the board
I2S_LRCLK: J11.1 (I2S_LRCLK), M1.9 (GPIO5); also elsewhere on the board
LCD_DC: J11.6 (LCD_DC), M1.14 (GPIO10); also elsewhere on the board
LCD_MOSI: J11.3 (LCD_MOSI), M1.11 (GPIO7); also elsewhere on the board
LCD_SCLK: J11.2 (LCD_SCLK), M1.10 (GPIO6); also elsewhere on the board
PAN_PWM: J12.2 (PAN_PWM), M1.5 (GPIO1); also elsewhere on the board
TOUCH: J12.4 (TOUCH), M1.7 (GPIO3); also elsewhere on the board
VOL_MINUS_N: J3.3 (VOL_MINUS_N); also elsewhere on the board
VOL_PLUS_N: J3.1 (VOL_PLUS_N); also elsewhere on the board

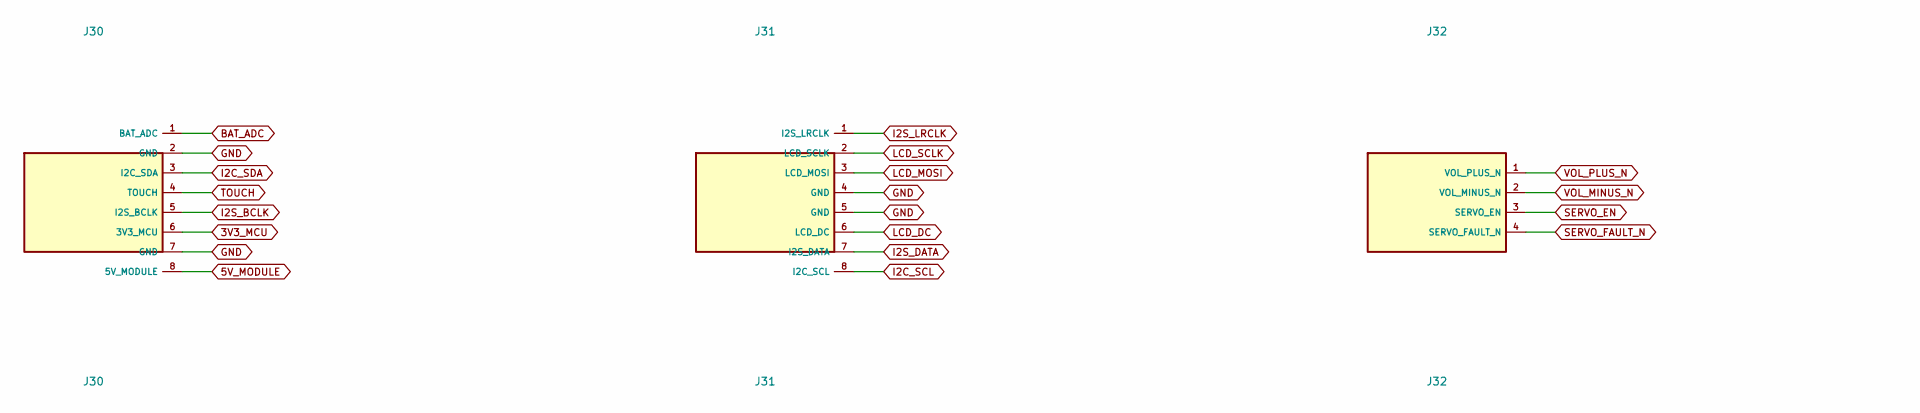
[picture p17: schematic Controller_Interface.kicad_sch, part in row 1, column 1]

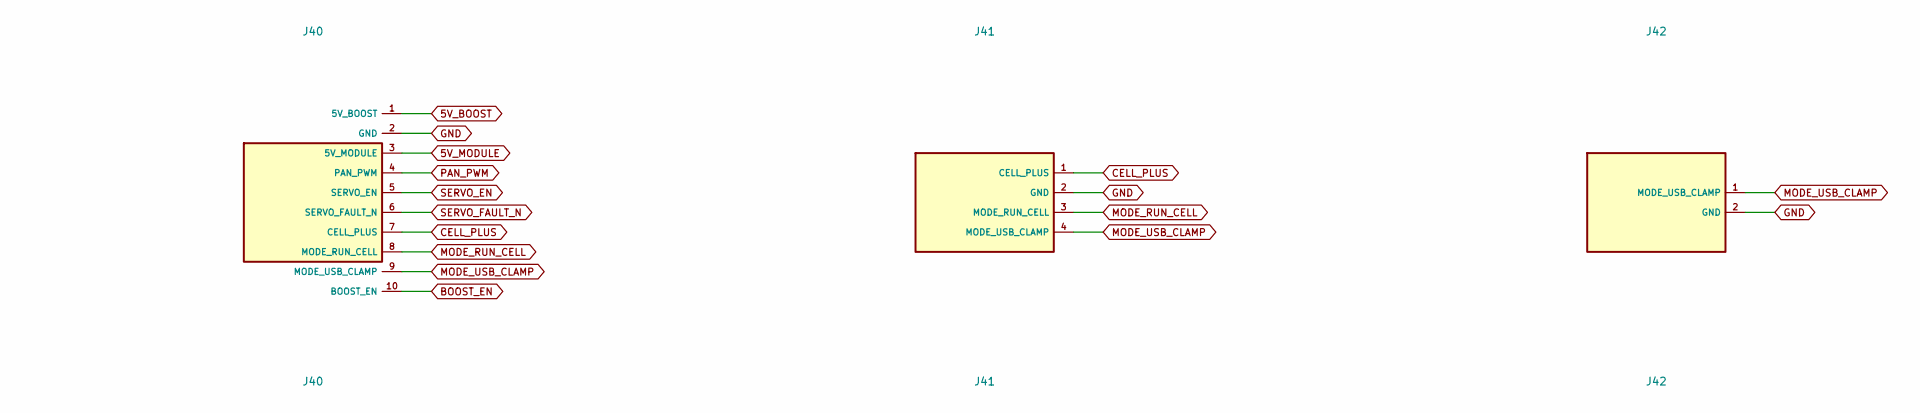
[picture p18: schematic Controller_Interface.kicad_sch, part in row 1, column 2]

Parts:
J30: J30; WirePads_8
J31: J31; WirePads_8
J32: J32; WirePads_4
J40: J40; PowerPads_10
J41: J41; WirePads_4
J42: J42; WirePads_2

Connections:
3V3_MCU: J30.6 (3V3_MCU); also elsewhere on the board
5V_BOOST: J40.1 (5V_BOOST); also elsewhere on the board
5V_MODULE: J30.8 (5V_MODULE), J40.3 (5V_MODULE); also elsewhere on the board
BAT_ADC: J30.1 (BAT_ADC); also elsewhere on the board
BOOST_EN: J40.10 (BOOST_EN); also elsewhere on the board
CELL_PLUS: J40.7 (CELL_PLUS), J41.1 (CELL_PLUS); also elsewhere on the board
GND: J30.2 (GND), J30.7 (GND), J31.4 (GND), J31.5 (GND), J40.2 (GND), J41.2 (GND), J42.2 (GND); also elsewhere on the board
I2C_SCL: J31.8 (I2C_SCL); also elsewhere on the board
I2C_SDA: J30.3 (I2C_SDA); also elsewhere on the board
I2S_BCLK: J30.5 (I2S_BCLK); also elsewhere on the board
I2S_DATA: J31.7 (I2S_DATA); also elsewhere on the board
I2S_LRCLK: J31.1 (I2S_LRCLK); also elsewhere on the board
LCD_DC: J31.6 (LCD_DC); also elsewhere on the board
LCD_MOSI: J31.3 (LCD_MOSI); also elsewhere on the board
LCD_SCLK: J31.2 (LCD_SCLK); also elsewhere on the board
MODE_RUN_CELL: J40.8 (MODE_RUN_CELL), J41.3 (MODE_RUN_CELL); also elsewhere on the board
MODE_USB_CLAMP: J40.9 (MODE_USB_CLAMP), J41.4 (MODE_USB_CLAMP), J42.1 (MODE_USB_CLAMP); also elsewhere on the board
PAN_PWM: J40.4 (PAN_PWM); also elsewhere on the board
SERVO_EN: J32.3 (SERVO_EN), J40.5 (SERVO_EN)
SERVO_FAULT_N: J32.4 (SERVO_FAULT_N), J40.6 (SERVO_FAULT_N)
TOUCH: J30.4 (TOUCH); also elsewhere on the board
VOL_MINUS_N: J32.2 (VOL_MINUS_N); also elsewhere on the board
VOL_PLUS_N: J32.1 (VOL_PLUS_N); also elsewhere on the board

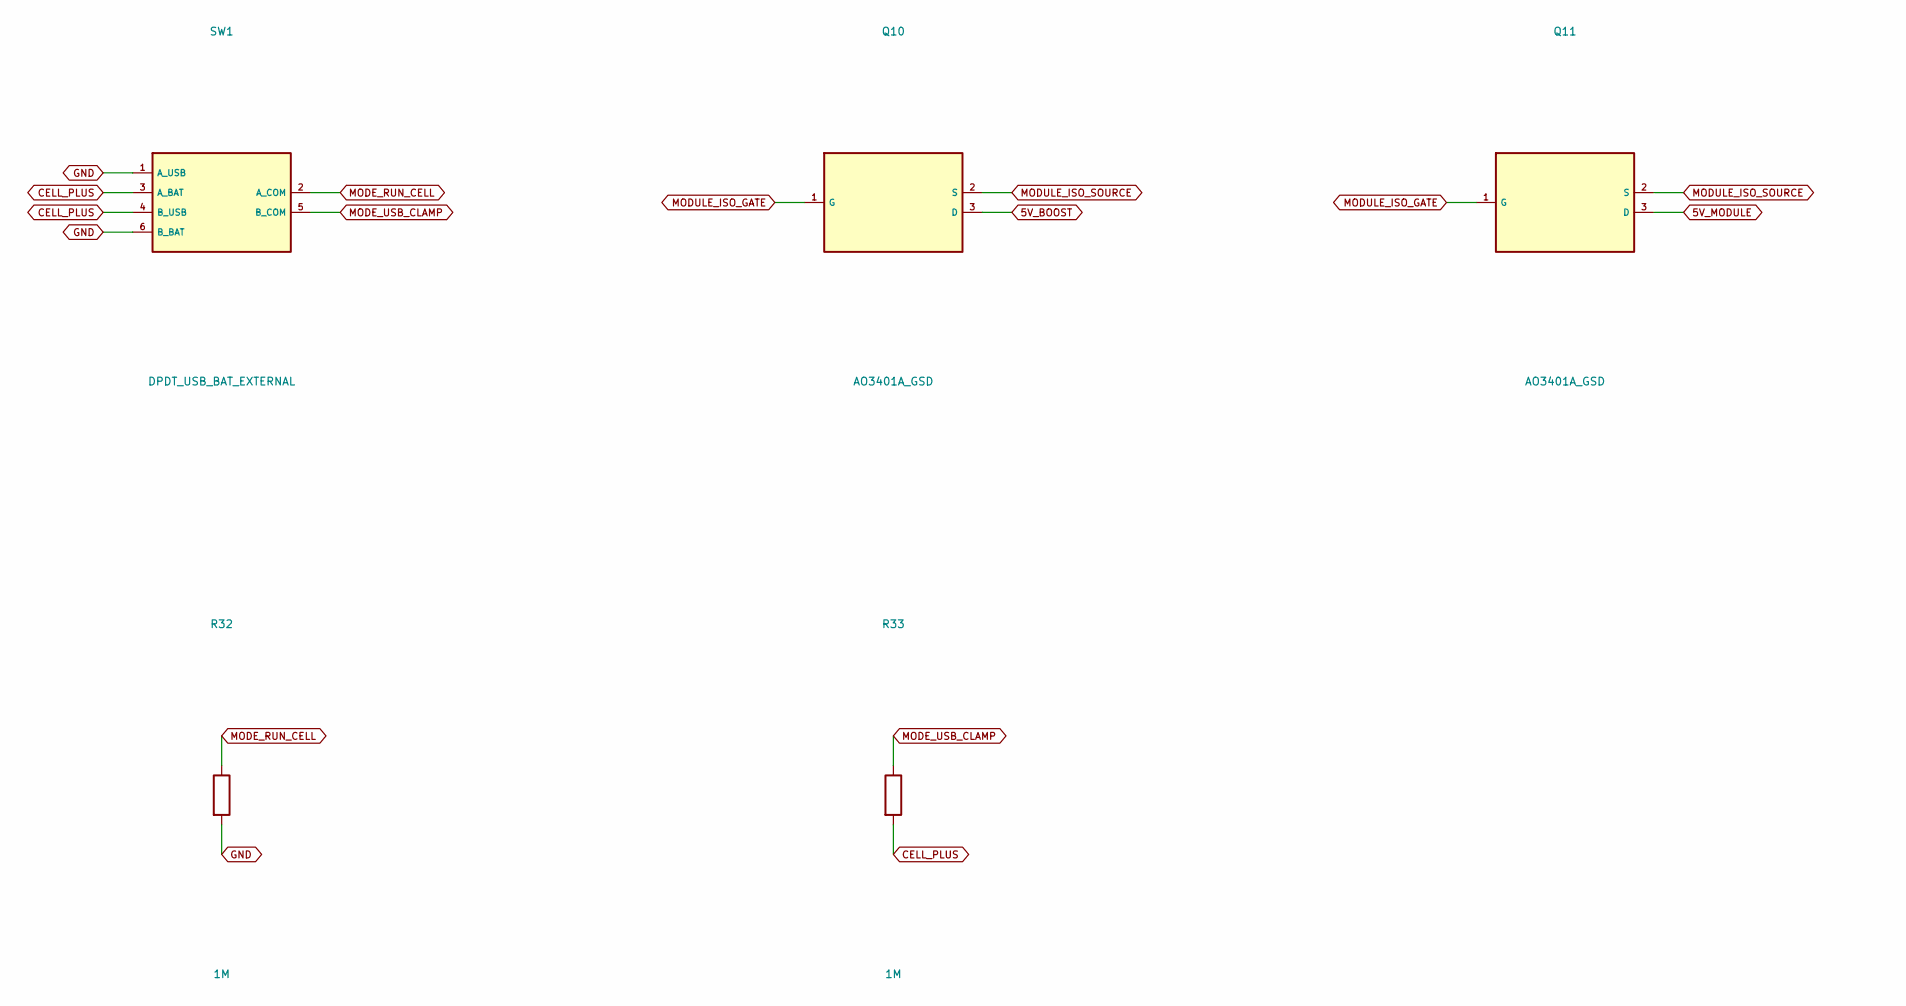
[picture p19: schematic Controller_USB_BAT_Mode.kicad_sch, part in row 1, column 1]

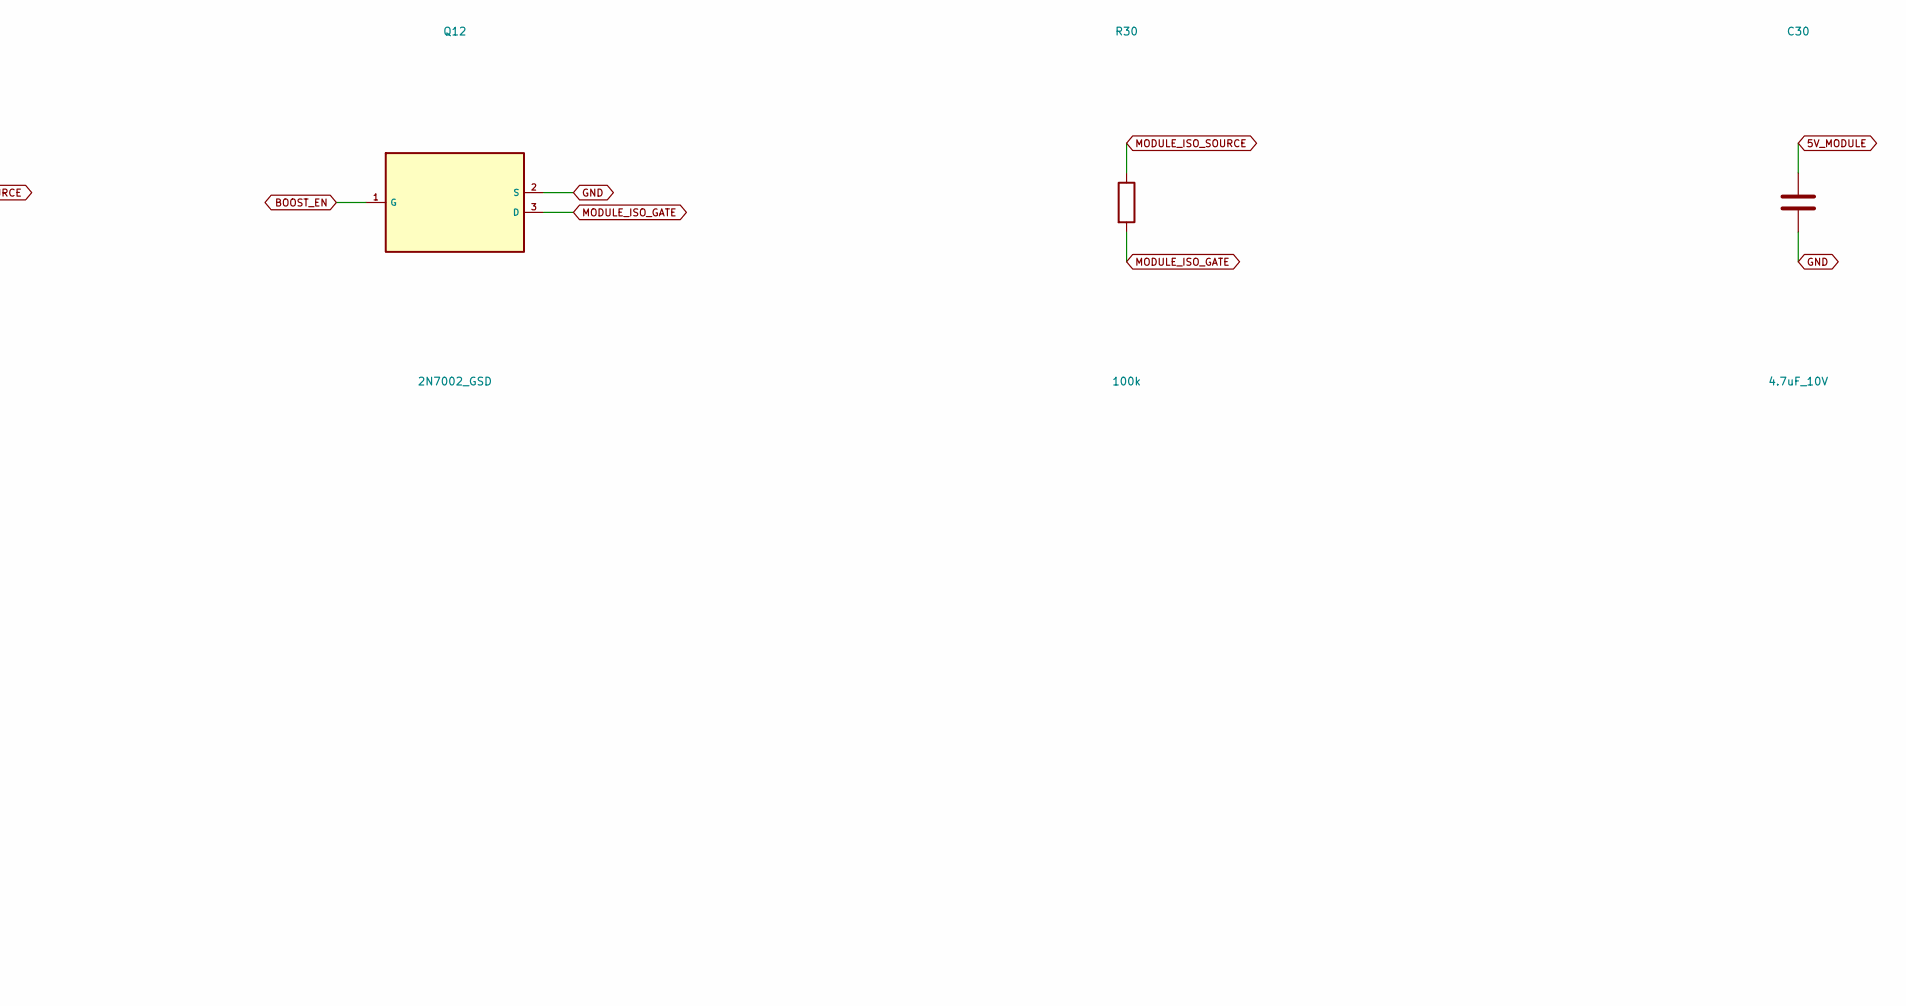
[picture p20: schematic Controller_USB_BAT_Mode.kicad_sch, part in row 1, column 2]

Parts:
C30: 4.7uF_10V; C_0603_1608Metric
Q10, Q11: AO3401A_GSD; SOT-23
Q12: 2N7002_GSD; SOT-23
R30: 100k; R_0603_1608Metric
R32, R33: 1M; R_0603_1608Metric
SW1: DPDT_USB_BAT_EXTERNAL

Connections:
5V_BOOST: Q10.3 (D); also elsewhere on the board
5V_MODULE: C30.1, Q11.3 (D); also elsewhere on the board
BOOST_EN: Q12.1 (G); also elsewhere on the board
CELL_PLUS: R33.2, SW1.3 (A_BAT), SW1.4 (B_USB); also elsewhere on the board
GND: C30.2, Q12.2 (S), R32.2, SW1.1 (A_USB), SW1.6 (B_BAT); also elsewhere on the board
MODE_RUN_CELL: R32.1, SW1.2 (A_COM); also elsewhere on the board
MODE_USB_CLAMP: R33.1, SW1.5 (B_COM); also elsewhere on the board
MODULE_ISO_GATE: Q10.1 (G), Q11.1 (G), Q12.3 (D), R30.2
MODULE_ISO_SOURCE: Q10.2 (S), Q11.2 (S), R30.1

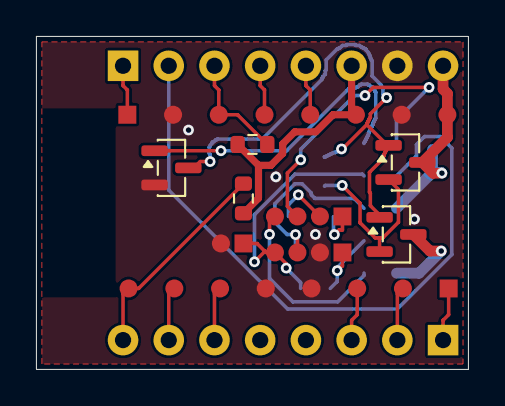
[picture p21: board DELTAX_V2_Controller.kicad_pcb from above]

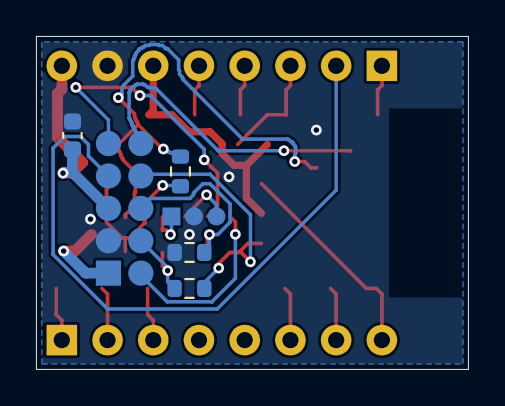
[picture p22: board DELTAX_V2_Controller.kicad_pcb from below]

Board: 2 copper layers, 24.0 x 18.5 mm, 18 parts (6 on the bottom side), 25 nets.
