im-deltax/Robodeltax/Dien_Tu/KiCad/Power/DELTAX_V2_Power.kicad_pcb

## KiCad design Dien_Tu/KiCad/Power/DELTAX_V2_Power.kicad_pcb (2026-10-22)

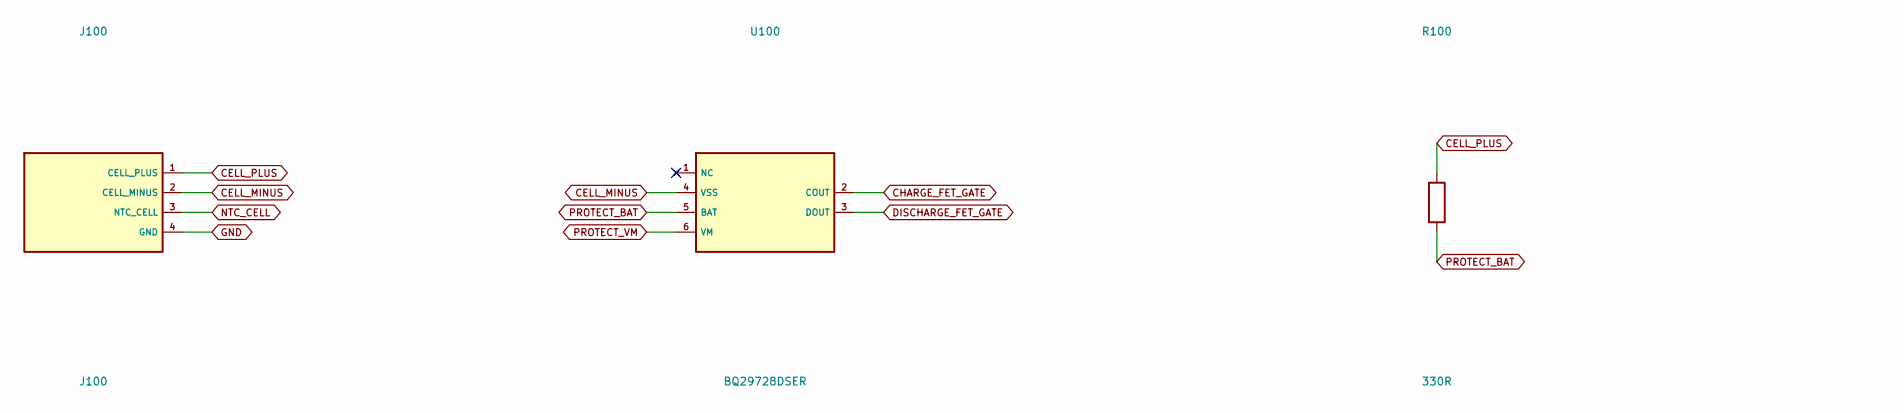
[picture p23: schematic Power_05_Cell_Protection.kicad_sch, part in row 1, column 1]

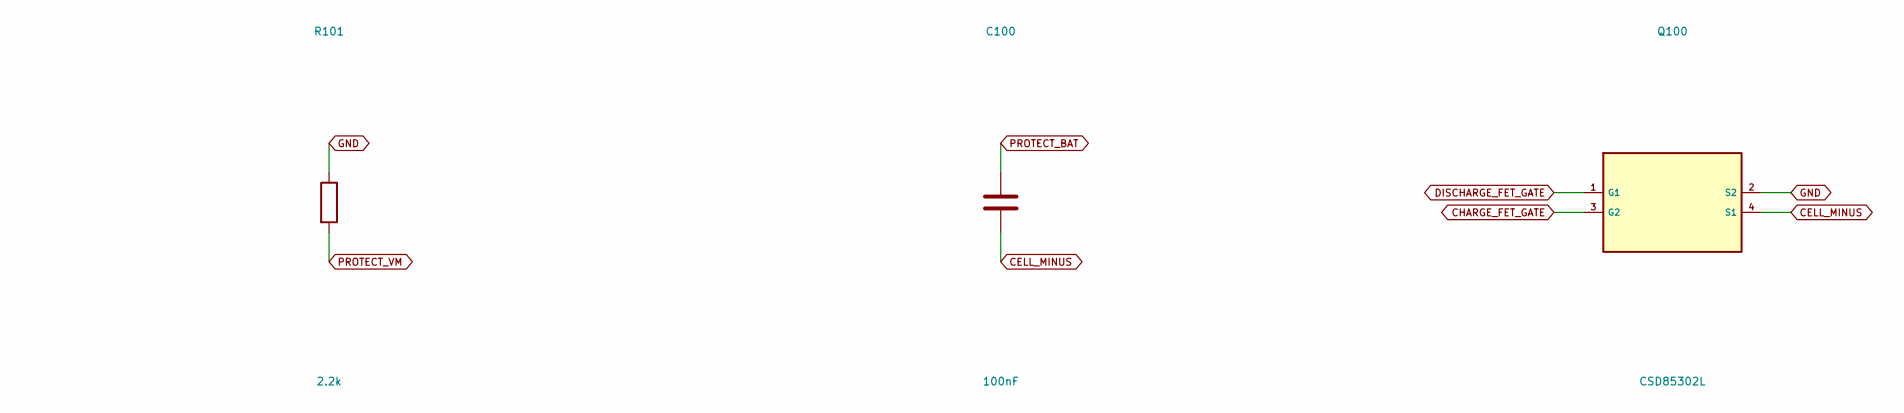
[picture p24: schematic Power_05_Cell_Protection.kicad_sch, part in row 1, column 2]

Parts:
C100: 100nF; C_0603_1608Metric
J100: J100; PowerPads_4
Q100: CSD85302L
R100: 330R; R_0603_1608Metric
R101: 2.2k; R_0603_1608Metric
U100: BQ29728DSER; WSON-6_1.5x1.5mm_P0.5mm

Connections:
CELL_MINUS: C100.2, J100.2 (CELL_MINUS), Q100.4 (S1), U100.4 (VSS)
CELL_PLUS: J100.1 (CELL_PLUS), R100.1; also elsewhere on the board
CHARGE_FET_GATE: Q100.3 (G2), U100.2 (COUT)
DISCHARGE_FET_GATE: Q100.1 (G1), U100.3 (DOUT)
GND: J100.4 (GND), Q100.2 (S2), R101.1; also elsewhere on the board
NTC_CELL: J100.3 (NTC_CELL); also elsewhere on the board
PROTECT_BAT: C100.1, R100.2, U100.5 (BAT)
PROTECT_VM: R101.2, U100.6 (VM)

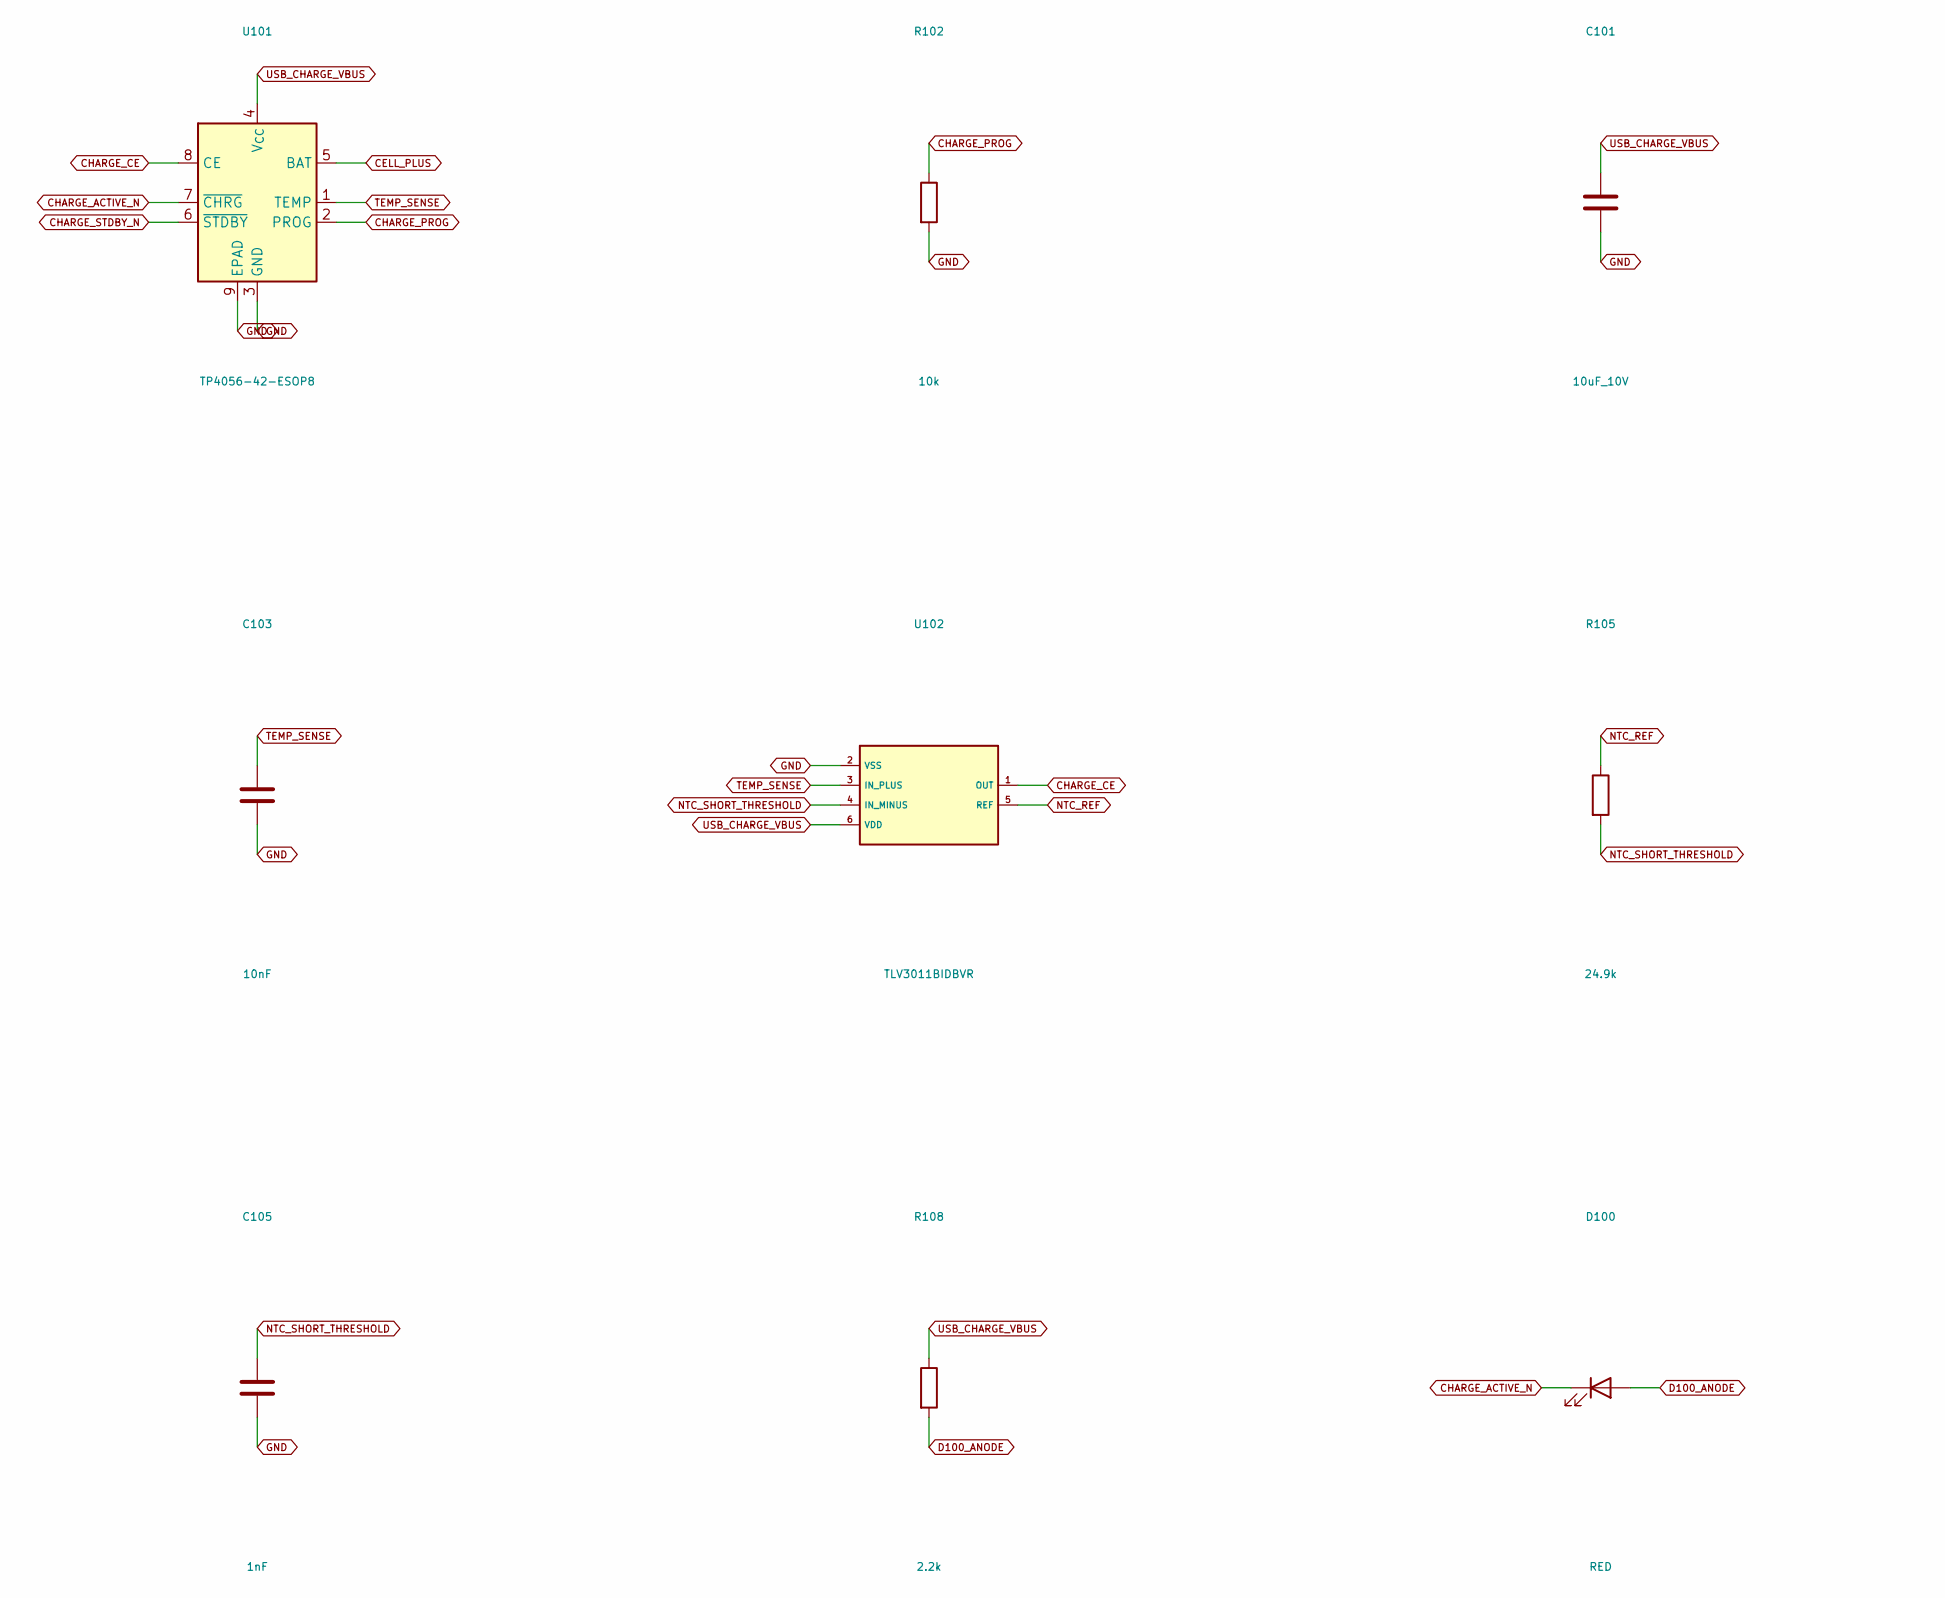
[picture p25: schematic Power_06_Charge_Temperature.kicad_sch, part in row 1, column 1]

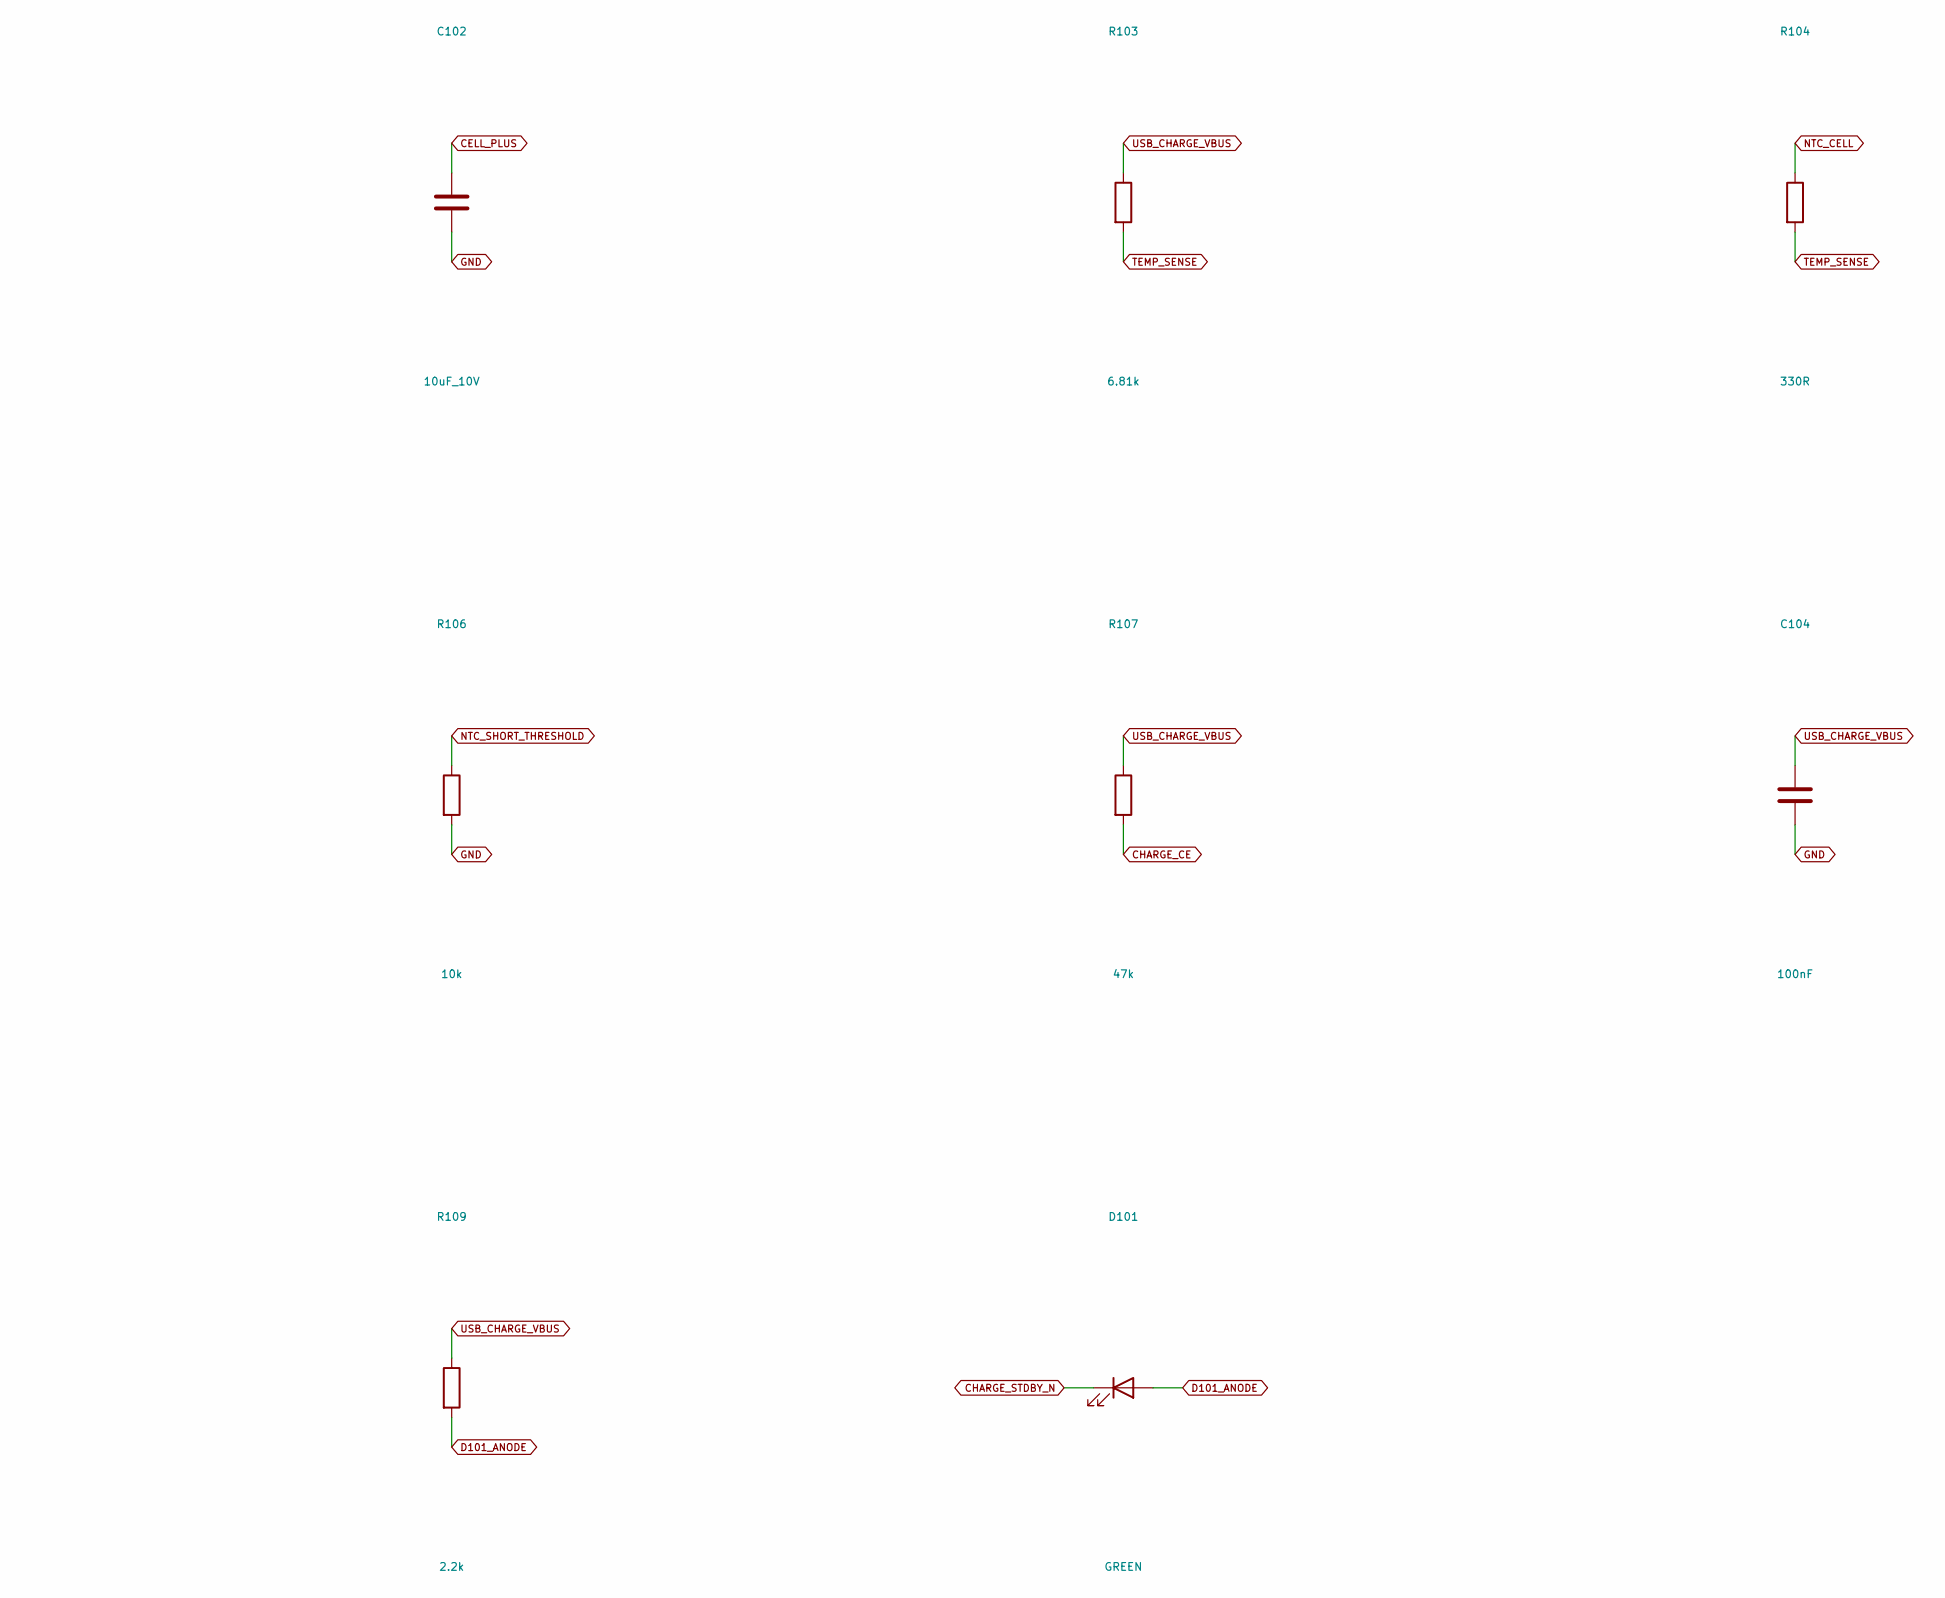
[picture p26: schematic Power_06_Charge_Temperature.kicad_sch, part in row 1, column 2]

Parts:
C101, C102: 10uF_10V; C_0805_2012Metric
C103: 10nF; C_0603_1608Metric
C104: 100nF; C_0603_1608Metric
C105: 1nF; C_0603_1608Metric
D100: RED; LED_0603_1608Metric
D101: GREEN; LED_0603_1608Metric
R102, R106: 10k; R_0603_1608Metric
R103: 6.81k; R_0603_1608Metric
R104: 330R; R_0603_1608Metric
R105: 24.9k; R_0603_1608Metric
R107: 47k; R_0603_1608Metric
R108, R109: 2.2k; R_0603_1608Metric
U101: TP4056-42-ESOP8; SOIC-8-1EP_3.9x4.9mm_P1.27mm_EP2.41x3.3mm
U102: TLV3011BIDBVR; SOT-23-6

Connections:
CELL_PLUS: C102.1, U101.5 (BAT); also elsewhere on the board
CHARGE_ACTIVE_N: D100.1 (K), U101.7 (~CHRG)
CHARGE_CE: R107.2, U101.8 (CE), U102.1 (OUT)
CHARGE_PROG: R102.1, U101.2 (PROG)
CHARGE_STDBY_N: D101.1 (K), U101.6 (~STDBY)
D100_ANODE: D100.2 (A), R108.2
D101_ANODE: D101.2 (A), R109.2
GND: C101.2, C102.2, C103.2, C104.2, C105.2, R102.2, R106.2, U101.3 (GND), U101.9 (EPAD), U102.2 (VSS); also elsewhere on the board
NTC_CELL: R104.1; also elsewhere on the board
NTC_REF: R105.1, U102.5 (REF)
NTC_SHORT_THRESHOLD: C105.1, R105.2, R106.1, U102.4 (IN_MINUS)
TEMP_SENSE: C103.1, R103.2, R104.2, U101.1 (TEMP), U102.3 (IN_PLUS)
USB_CHARGE_VBUS: C101.1, C104.1, R103.1, R107.1, R108.1, R109.1, U101.4 (V_{CC}), U102.6 (VDD); also elsewhere on the board
