im-deltax/Robodeltax/Dien_Tu/KiCad/Power/DELTAX_V2_Power.kicad_pcb

## KiCad design Dien_Tu/KiCad/Power/DELTAX_V2_Power.kicad_pcb (continued)

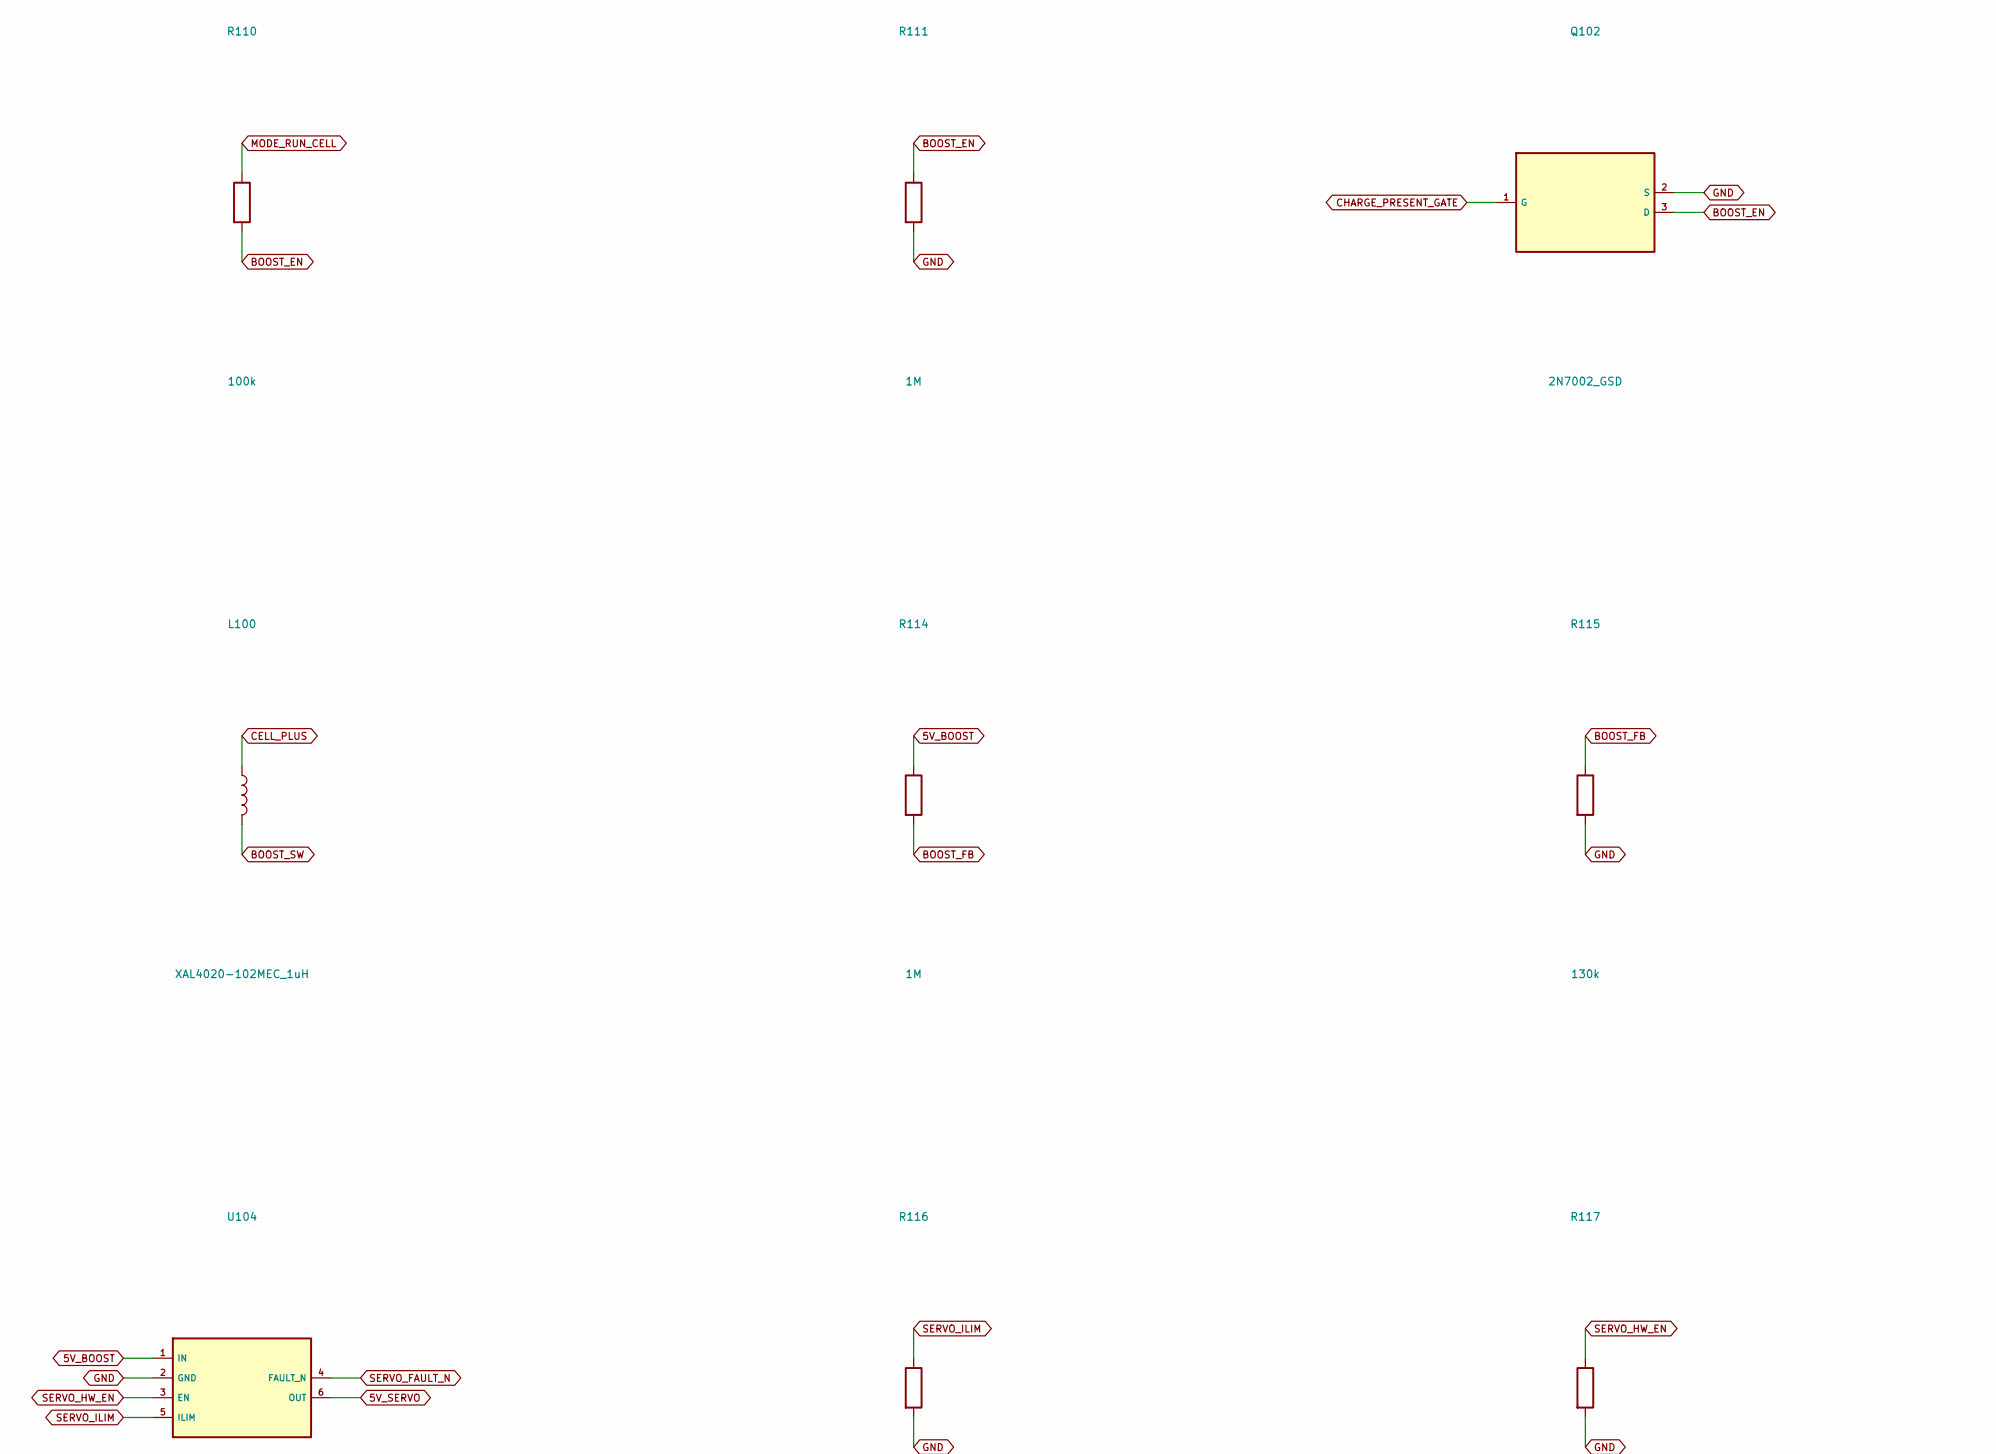
[picture p27: schematic Power_07_Boost_Servo.kicad_sch, part in row 1, column 1]

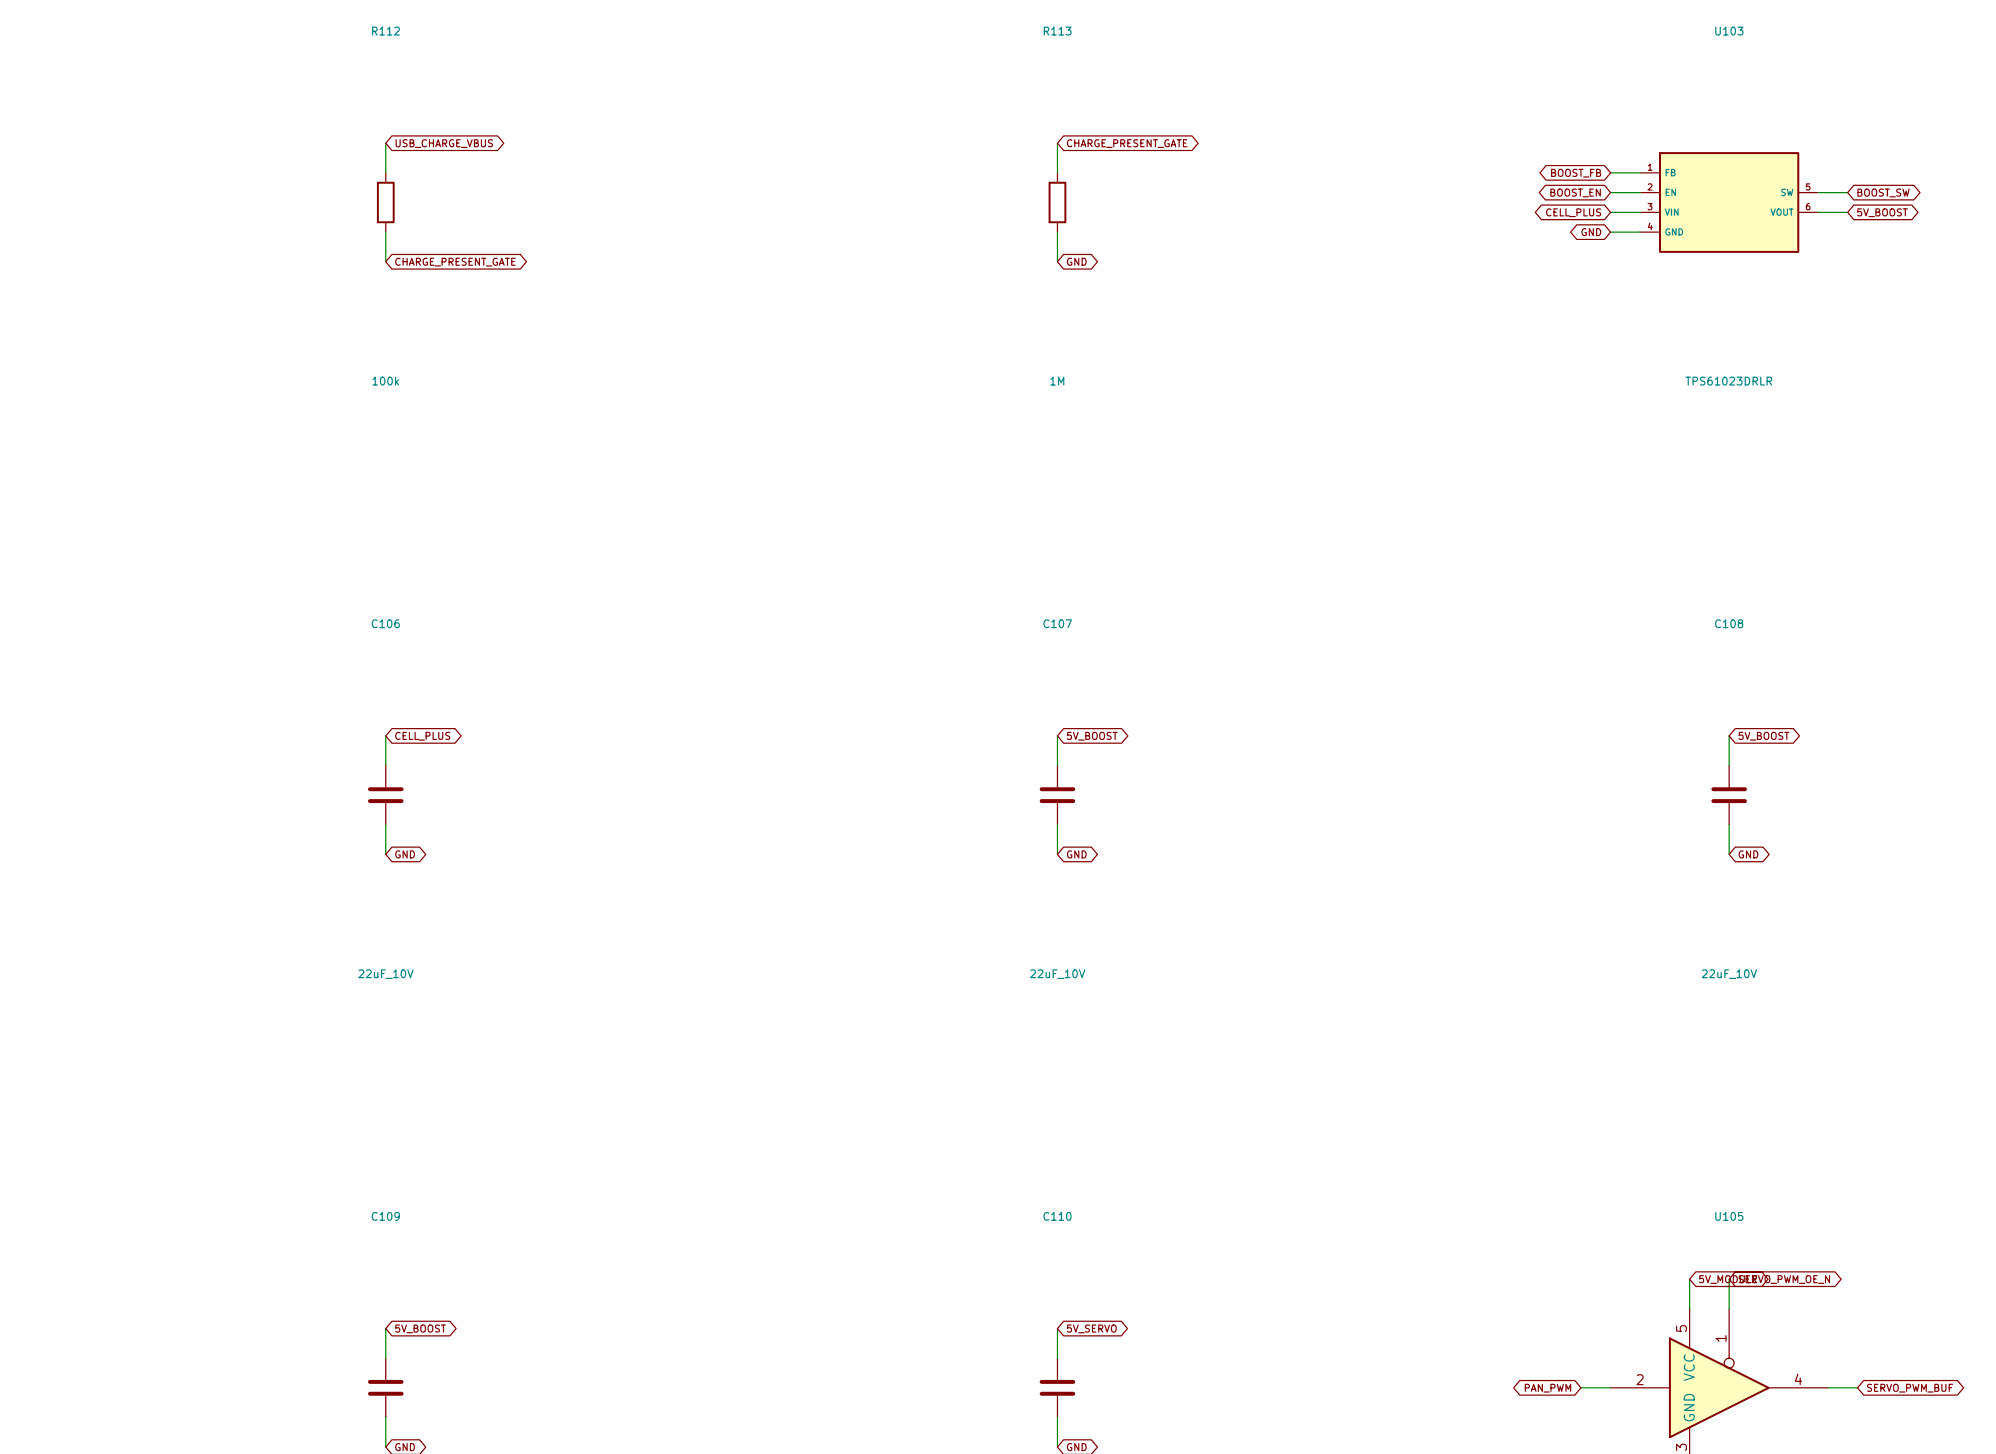
[picture p28: schematic Power_07_Boost_Servo.kicad_sch, part in row 1, column 2]

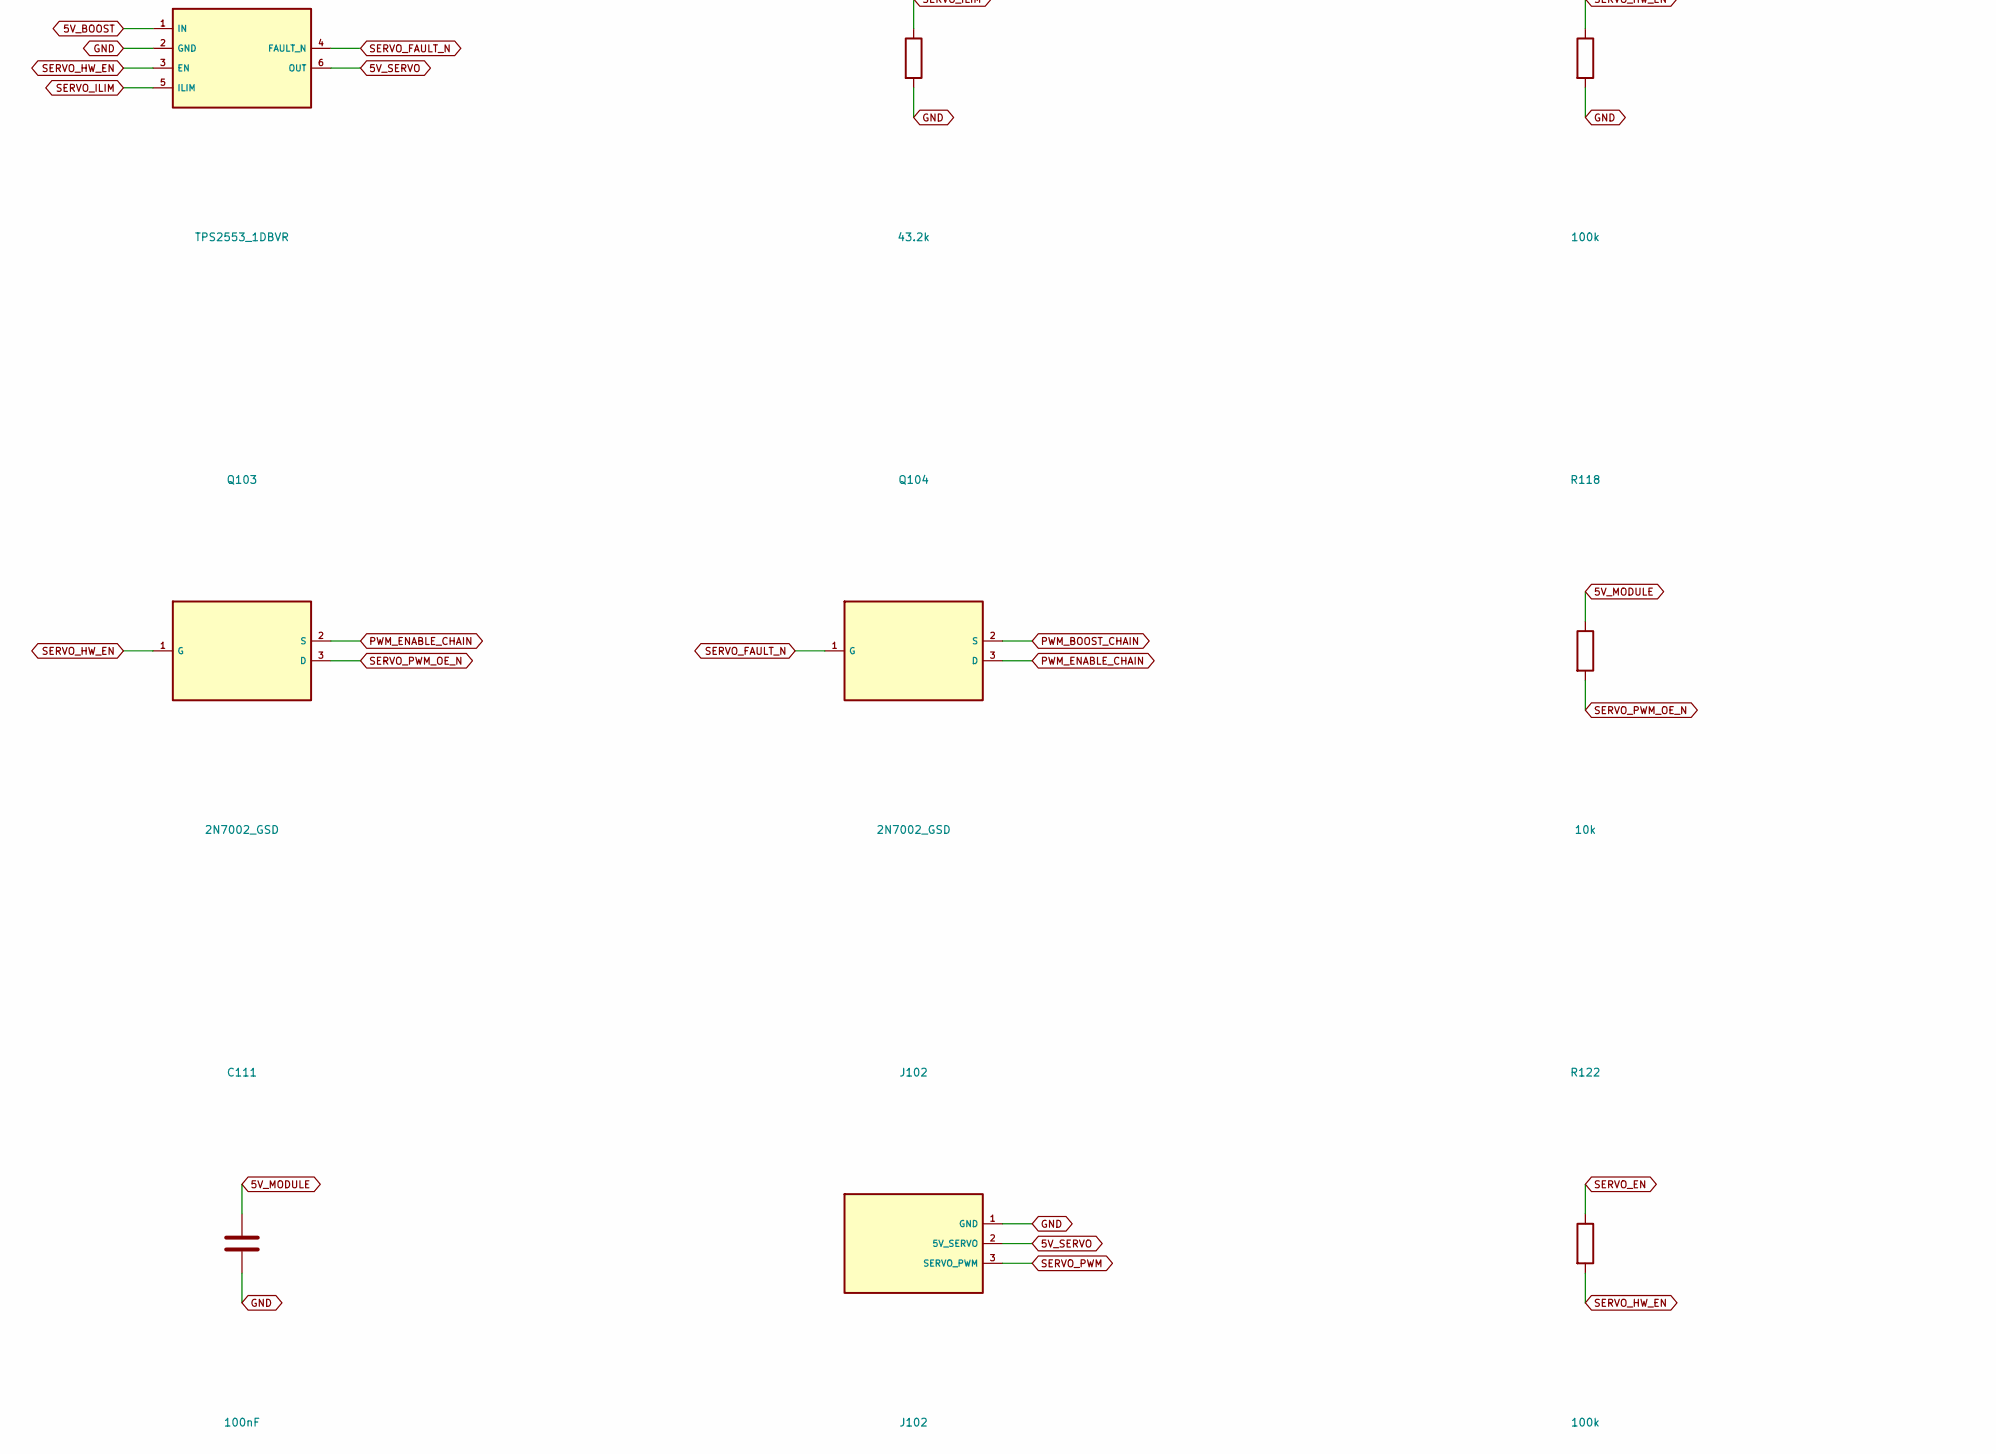
[picture p29: schematic Power_07_Boost_Servo.kicad_sch, part in row 2, column 1]

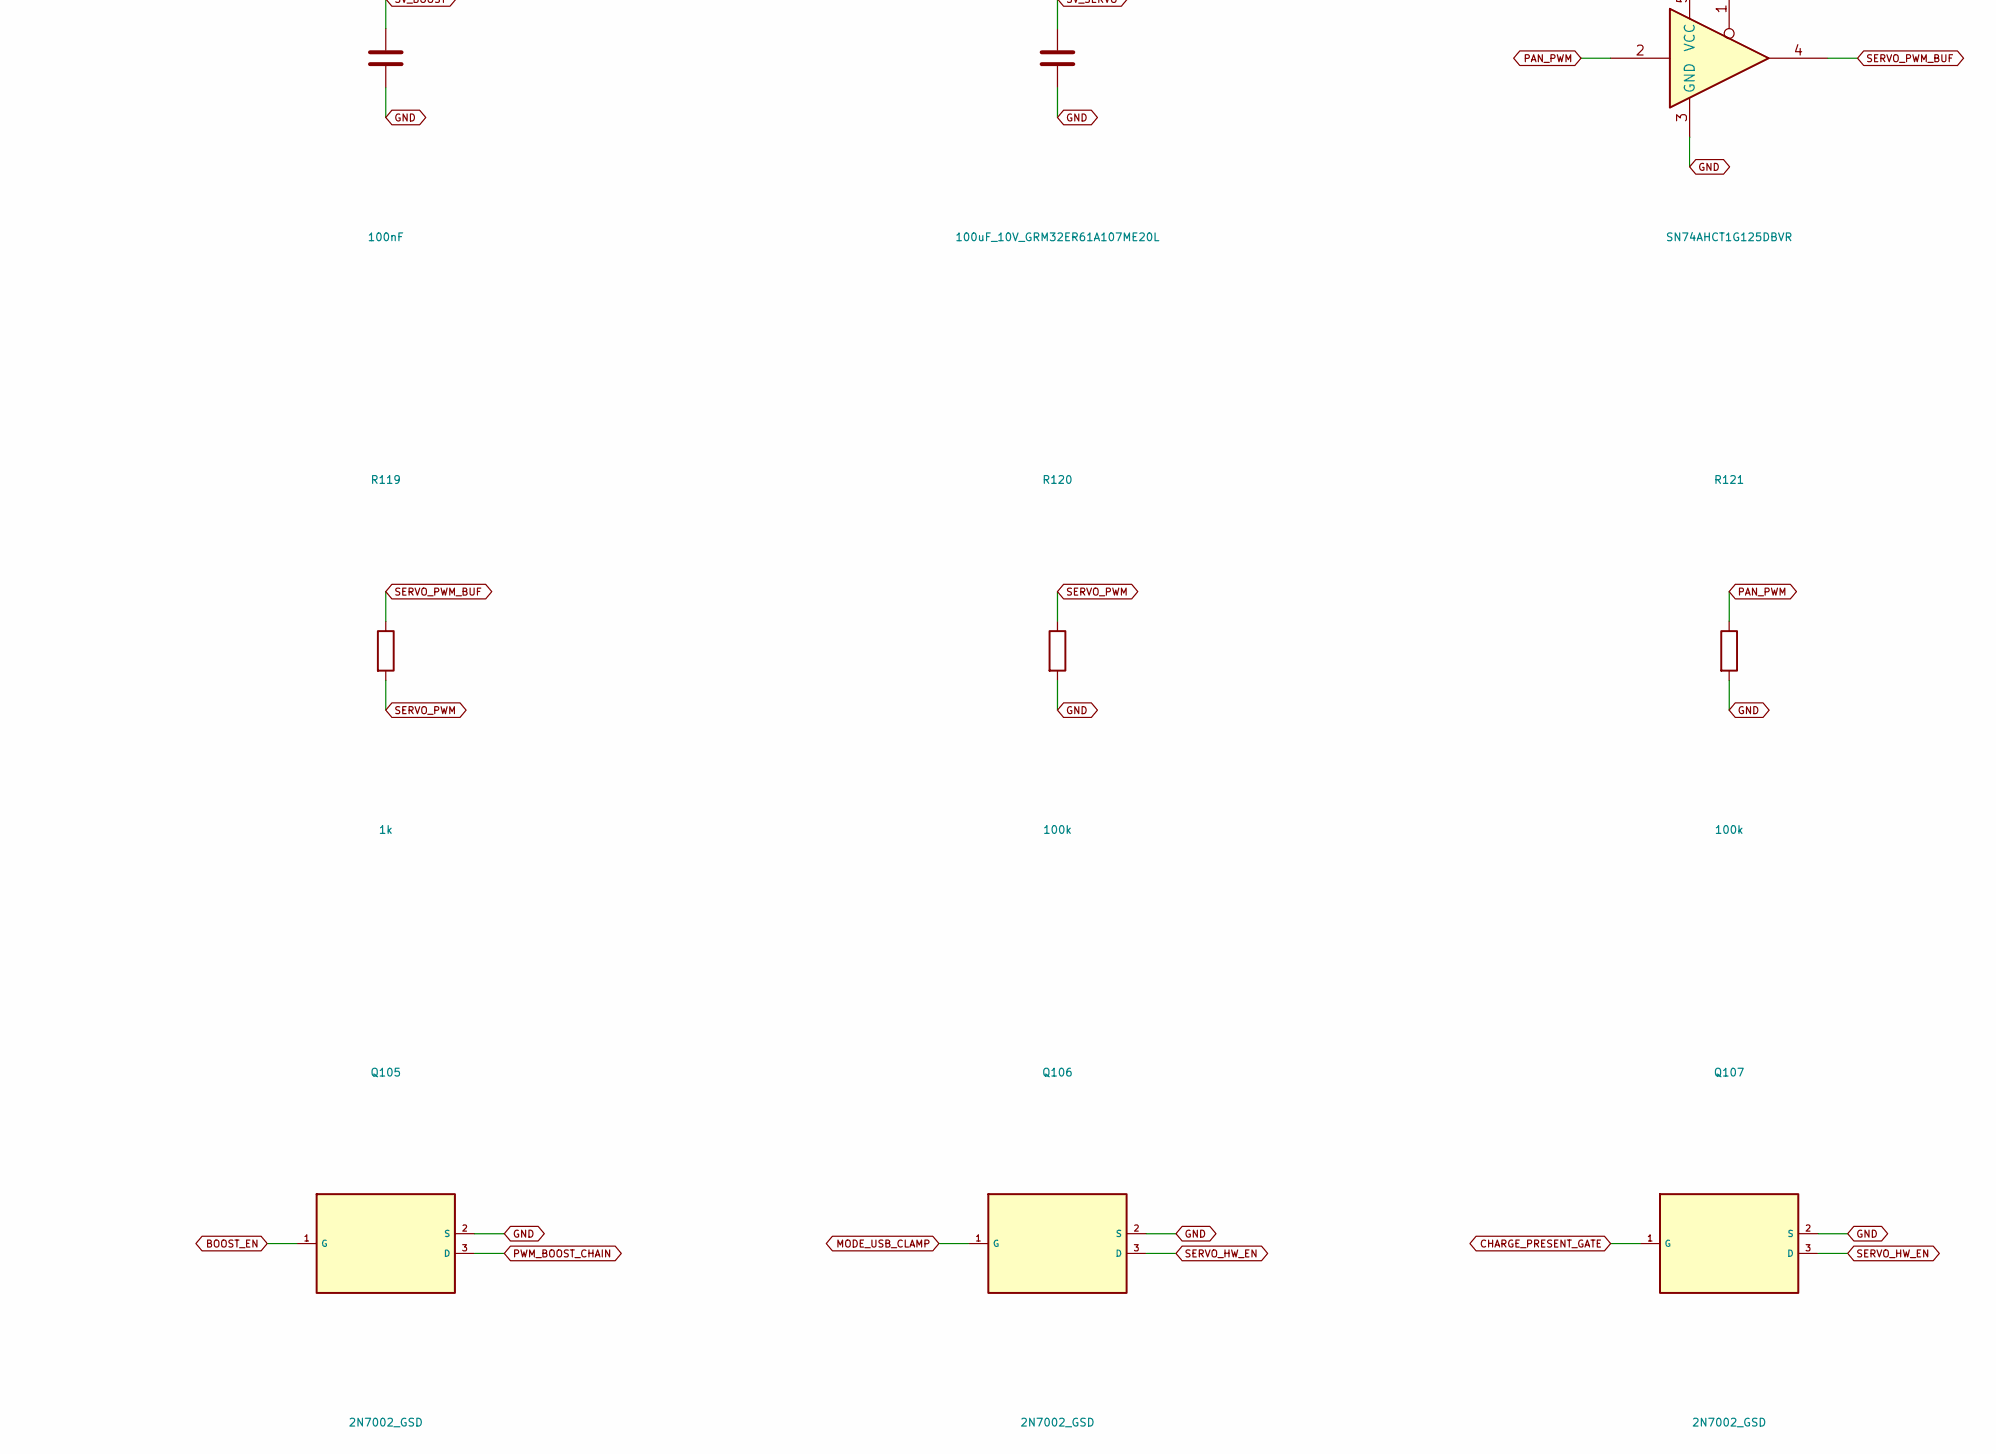
[picture p30: schematic Power_07_Boost_Servo.kicad_sch, part in row 2, column 2]

Parts:
C106, C107, C108: 22uF_10V; C_0805_2012Metric
C109: 100nF; C_0603_1608Metric
C110: 100uF_10V_GRM32ER61A107ME20L; C_1210_3225Metric
C111: 100nF; C_0402_1005Metric
J102: J102; PowerPads_3
L100: XAL4020-102MEC_1uH; L_Coilcraft_XAL4020-XXX
Q102, Q103, Q104, Q105, Q106, Q107: 2N7002_GSD; SOT-23
R110, R112, R117, R120, R121, R122: 100k; R_0603_1608Metric
R111, R113, R114: 1M; R_0603_1608Metric
R115: 130k; R_0603_1608Metric
R116: 43.2k; R_0603_1608Metric
R118: 10k; R_0603_1608Metric
R119: 1k; R_0603_1608Metric
U103: TPS61023DRLR; SOT-563
U104: TPS2553_1DBVR; SOT-23-6
U105: SN74AHCT1G125DBVR; SOT-23-5

Connections:
5V_BOOST: C107.1, C108.1, C109.1, R114.1, U103.6 (VOUT), U104.1 (IN); also elsewhere on the board
5V_MODULE: C111.1, R118.1, U105.5 (VCC); also elsewhere on the board
5V_SERVO: C110.1, J102.2 (5V_SERVO), U104.6 (OUT)
BOOST_EN: Q102.3 (D), Q105.1 (G), R110.2, R111.1, U103.2 (EN); also elsewhere on the board
BOOST_FB: R114.2, R115.1, U103.1 (FB)
BOOST_SW: L100.2, U103.5 (SW)
CELL_PLUS: C106.1, L100.1, U103.3 (VIN); also elsewhere on the board
CHARGE_PRESENT_GATE: Q102.1 (G), Q107.1 (G), R112.2, R113.1
GND: C106.2, C107.2, C108.2, C109.2, C110.2, C111.2, J102.1 (GND), Q102.2 (S), Q105.2 (S), Q106.2 (S), Q107.2 (S), R111.2, R113.2, R115.2, R116.2, R117.2, R120.2, R121.2, U103.4 (GND), U104.2 (GND), U105.3 (GND); also elsewhere on the board
MODE_RUN_CELL: R110.1; also elsewhere on the board
MODE_USB_CLAMP: Q106.1 (G); also elsewhere on the board
PAN_PWM: R121.1, U105.2; also elsewhere on the board
PWM_BOOST_CHAIN: Q104.2 (S), Q105.3 (D)
PWM_ENABLE_CHAIN: Q103.2 (S), Q104.3 (D)
SERVO_EN: R122.1; also elsewhere on the board
SERVO_FAULT_N: Q104.1 (G), U104.4 (FAULT_N); also elsewhere on the board
SERVO_HW_EN: Q103.1 (G), Q106.3 (D), Q107.3 (D), R117.1, R122.2, U104.3 (EN)
SERVO_ILIM: R116.1, U104.5 (ILIM)
SERVO_PWM: J102.3 (SERVO_PWM), R119.2, R120.1
SERVO_PWM_BUF: R119.1, U105.4
SERVO_PWM_OE_N: Q103.3 (D), R118.2, U105.1
USB_CHARGE_VBUS: R112.1; also elsewhere on the board

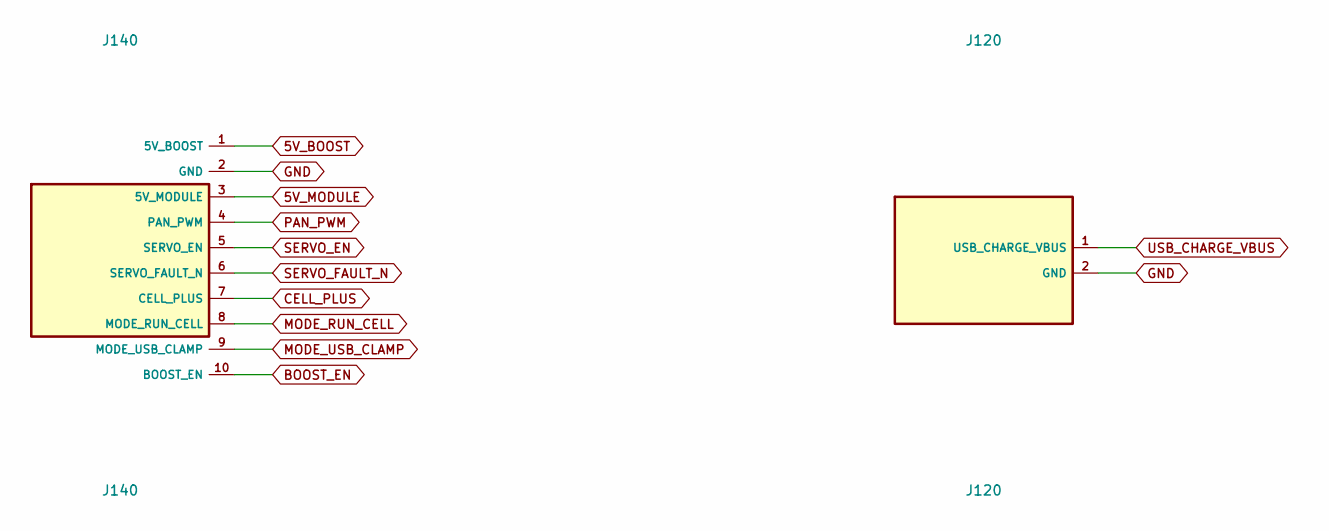
[picture p31: schematic Power_Interface.kicad_sch]

Parts:
J120: J120; PowerPads_2
J140: J140; PowerPads_10

Connections:
5V_BOOST: J140.1 (5V_BOOST); also elsewhere on the board
5V_MODULE: J140.3 (5V_MODULE); also elsewhere on the board
BOOST_EN: J140.10 (BOOST_EN); also elsewhere on the board
CELL_PLUS: J140.7 (CELL_PLUS); also elsewhere on the board
GND: J120.2 (GND), J140.2 (GND); also elsewhere on the board
MODE_RUN_CELL: J140.8 (MODE_RUN_CELL); also elsewhere on the board
MODE_USB_CLAMP: J140.9 (MODE_USB_CLAMP); also elsewhere on the board
PAN_PWM: J140.4 (PAN_PWM); also elsewhere on the board
SERVO_EN: J140.5 (SERVO_EN); also elsewhere on the board
SERVO_FAULT_N: J140.6 (SERVO_FAULT_N); also elsewhere on the board
USB_CHARGE_VBUS: J120.1 (USB_CHARGE_VBUS); also elsewhere on the board

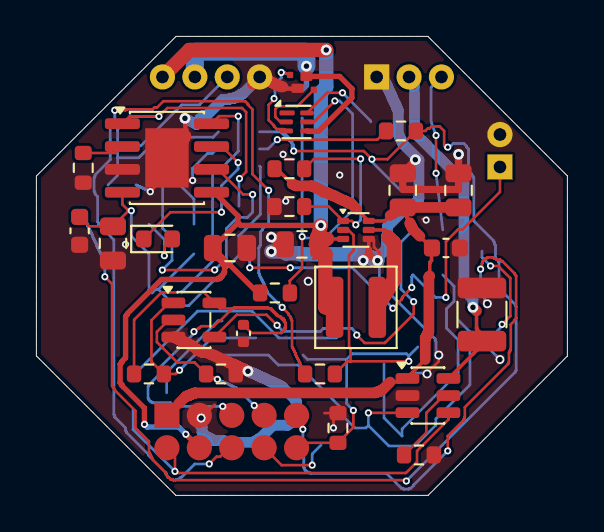
[picture p32: board DELTAX_V2_Power.kicad_pcb from above]

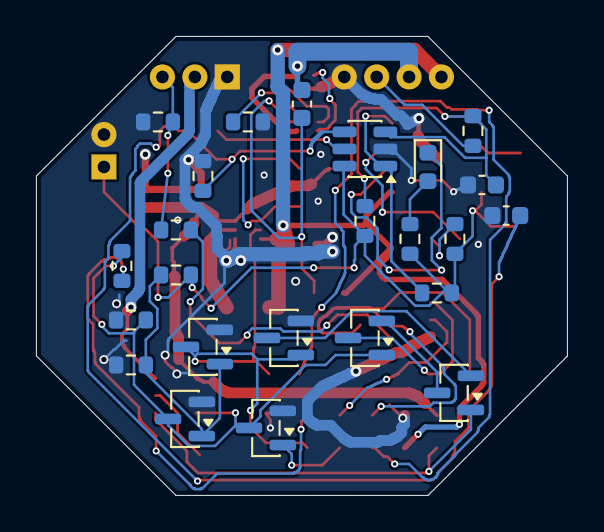
[picture p33: board DELTAX_V2_Power.kicad_pcb from below]

Board: 2 copper layers, 29.5 x 25.5 mm, 55 parts (24 on the bottom side), 37 nets.
