im-deltax/Robodeltax/(commit log)

2026-10-22 Publish initial robot design assets and development status
    [02_Rap_Hoodie_Rong_Tim_mm.dxf, 02_Rap_V11_mm.dxf, 05_Danh_muc_cat_vai.csv, A_DeltaX_Engraved_Nameplate.step, A_DeltaX_Engraved_Nameplate.stl, A_DeltaX_Recessed_Gold_Inlay.step, A_DeltaX_Recessed_Gold_Inlay.stl, ArmLeft.step]
2026-10-22 License author-owned Robodeltax materials under GPL-3.0-only
